tregatti-tech/ESP32ECG/Visualisation/tregatti_stable_front.jpg

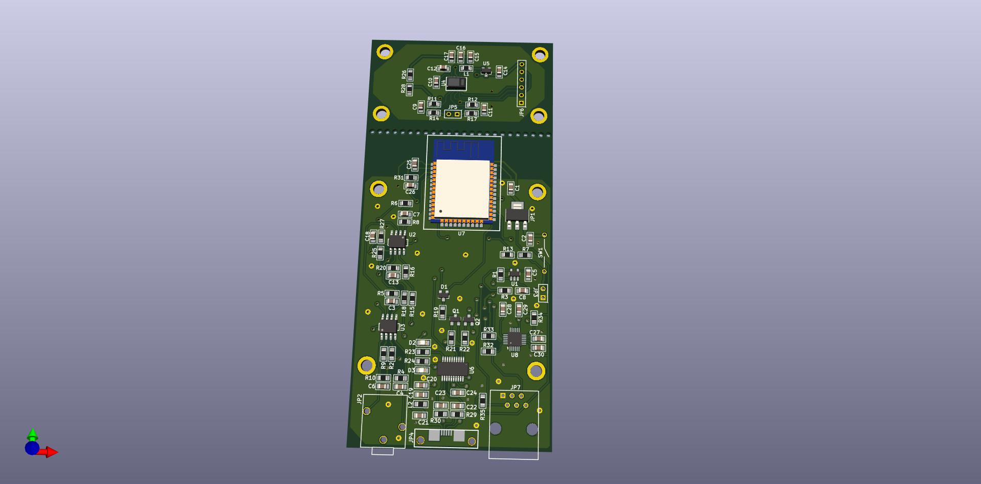
Visualisation/tregatti_stable_front.jpg
