tregatti-tech/ESP32ECG/README.md

# ESP32ECG
Open design/code version of ECG device based on esp32

Website https://tregatti.tech
Email info@
