tregatti-tech/ESP32ECG/Presentations/DevBG_IoT.pdf

v

Следете актуалните обяви за Internet of things

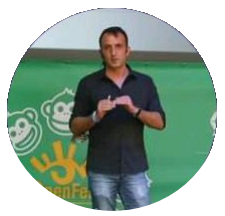
[picture p2: figure]

# Примерен код за кардиография чрез esp32

таймер, ацп(adc), филтри, i2c, websocket, canvas, etc.

Петко Маринов

Ладоре ООД

# Сигналът

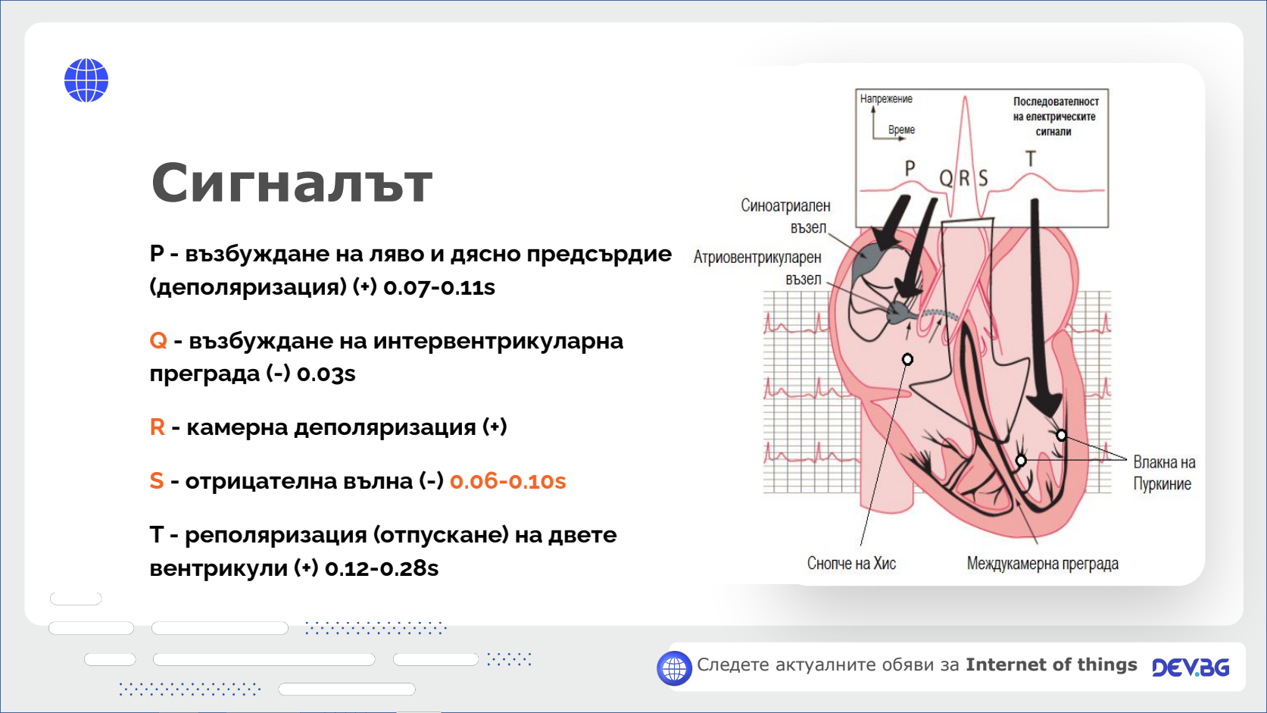
[picture p3: page 2]

v

P - възбуждане на ляво и дясно предсърдие (деполяризация) (+) 0.07-0.11s

Q - възбуждане на интервентрикуларна преграда (-) 0.03s

R - камерна деполяризация (+)

S - отрицателна вълна (-) 0.06-0.10s

Т - реполяризация (отпускане) на двете вентрикули (+) 0.12-0.28s

# Усилвателя

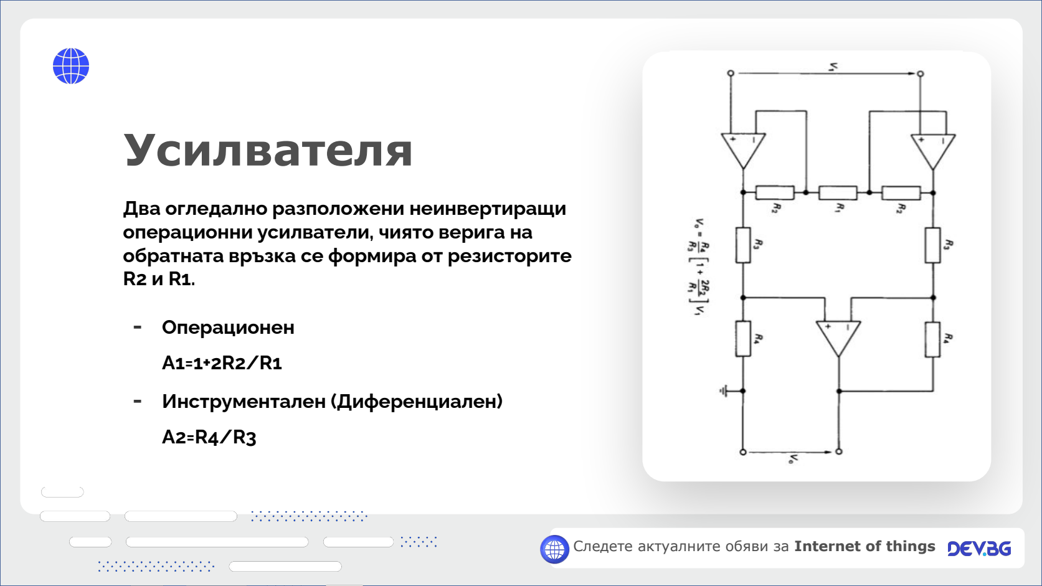
[picture p4: page 3]

v

Два огледално разположени неинвертиращи операционни усилватели, чиято верига на обратната връзка се формира от резисторите R2 и R1.

- Операционен
A1=1+2R2/R1
- Инструментален (Диференциален) A2=R4/R3

# АЦП/ADC

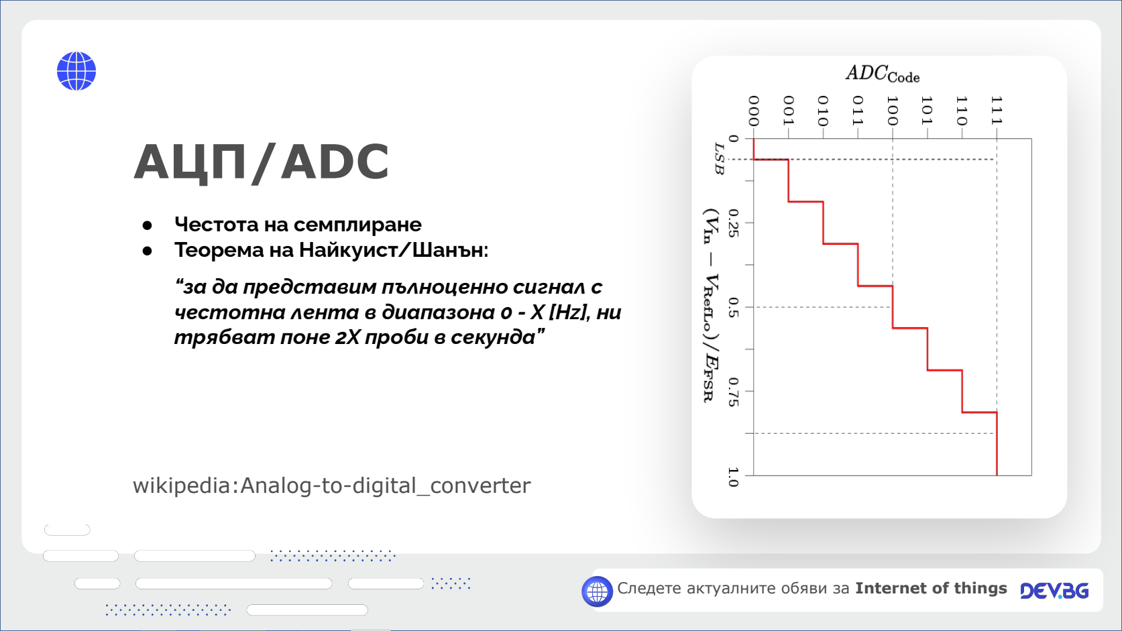
[picture p5: page 4]

v

- Честота на семплиране
- Теорема на Найкуист/Шанън:
“за да представим пълноценно сигнал с честотна лента в диапазона 0 - Х [Hz], ни трябват поне 2Х проби в секунда”

wikipedia:Analog-to-digital_converter

# esp32 АЦП/ADC

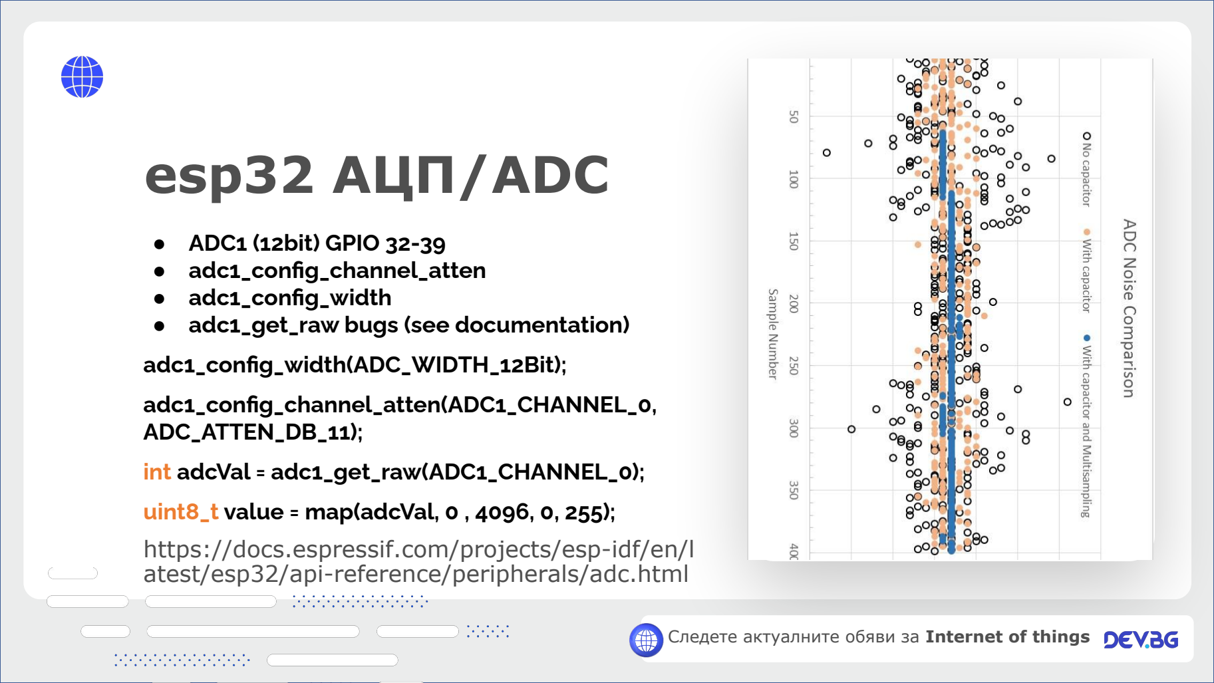
[picture p6: page 5]

v

- ADC1 (12bit) GPIO 32-39
- adc1_config_channel_atten
- adc1_config_width
- adc1_get_raw bugs (see documentation) adc1_config_width(ADC_WIDTH_12Bit); adc1_config_channel_atten(ADC1_CHANNEL_0, ADC_ATTEN_DB_11);
int adcVal = adc1_get_raw(ADC1_CHANNEL_0); uint8_t value = map(adcVal, 0 , 4096, 0, 255);

https://docs.espressif.com/projects/esp-idf/en/latest/esp32/api-reference/peripherals/adc.html

# Timer-esp32

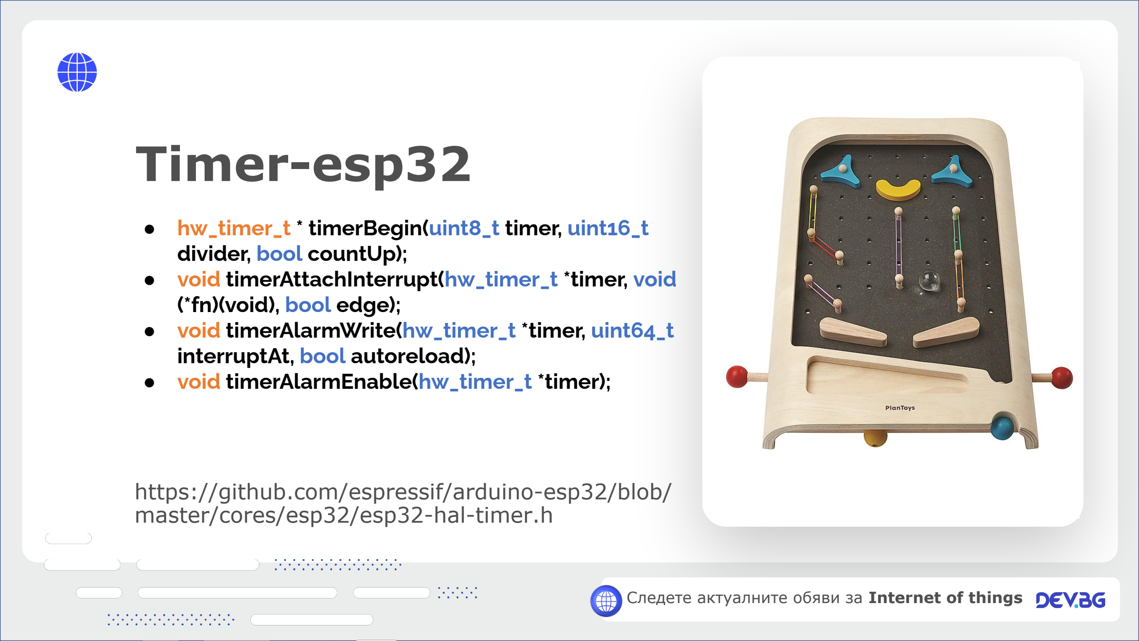
[picture p7: page 6]

v

- hw_timer_t * timerBegin(uint8_t timer, uint16_t divider, bool countUp);
- void timerAttachInterrupt(hw_timer_t *timer, void (*fn)(void), bool edge);
- void timerAlarmWrite(hw_timer_t *timer, uint64_t interruptAt, bool autoreload);
- void timerAlarmEnable(hw_timer_t *timer);

https://github.com/espressif/arduino-esp32/blob/master/cores/esp32/esp32-hal-timer.h

v

hw_timer_t * timer = NULL;
portMUX_TYPE timerMutex = portMUX_INITIALIZER_UNLOCKED; int main(void) { //snip …
//…

timer = timerBegin(0, 80, true); // 80 is the divider timerAttachInterrupt(timer, &onTimer, true); timerAlarmWrite(timer, 4000, true);//4000 == 250/second timerAlarmEnable(timer);
}

v

#include <driver/adc.h>

void IRAM_ATTR onTimer() { //portENTER_CRITICAL_ISR(&timerMutex);

int adcVal = adc1_get_raw(ADC1_CHANNEL_0); uint8_t value = map(adcVal, 0 , 4096, 0, 255); ekgBuffer[bufferPointer++] = value;

if (bufferPointer == EKG_BUFFER_MAX ) { bufferPointer = 0;
transmit = true;
}
//portEXIT_CRITICAL_ISR(&timerMutex); }

# Шум

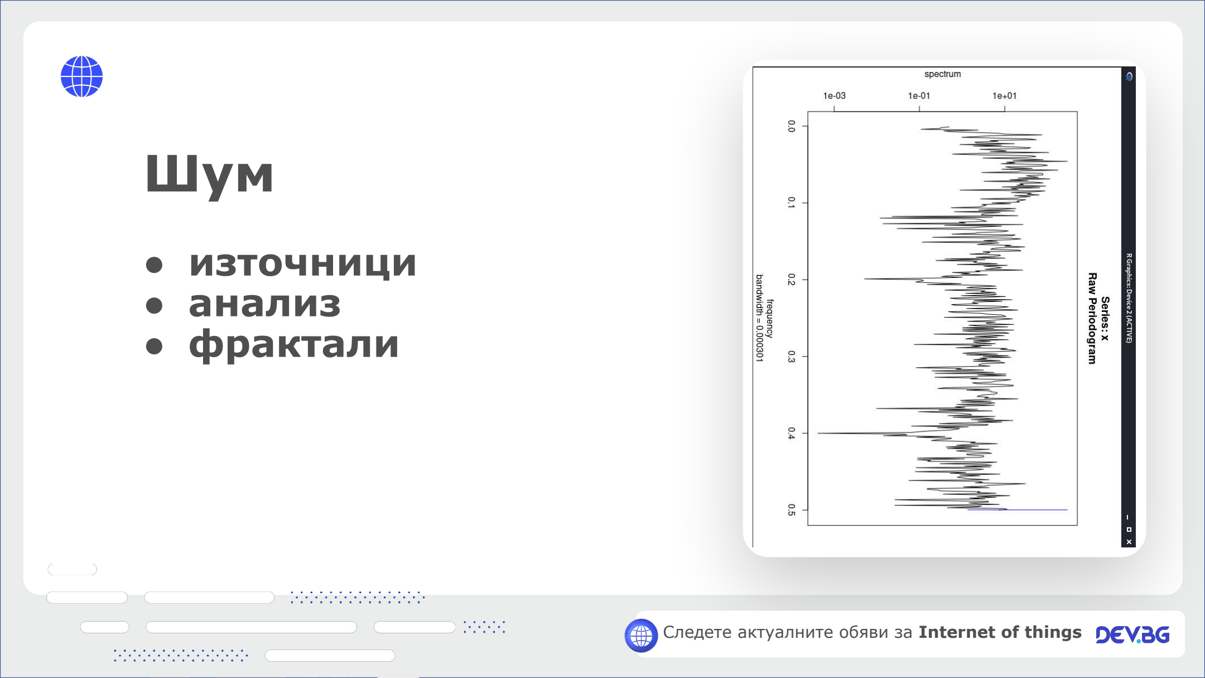
[picture p8: page 9]

v

## - източници - анализ - фрактали

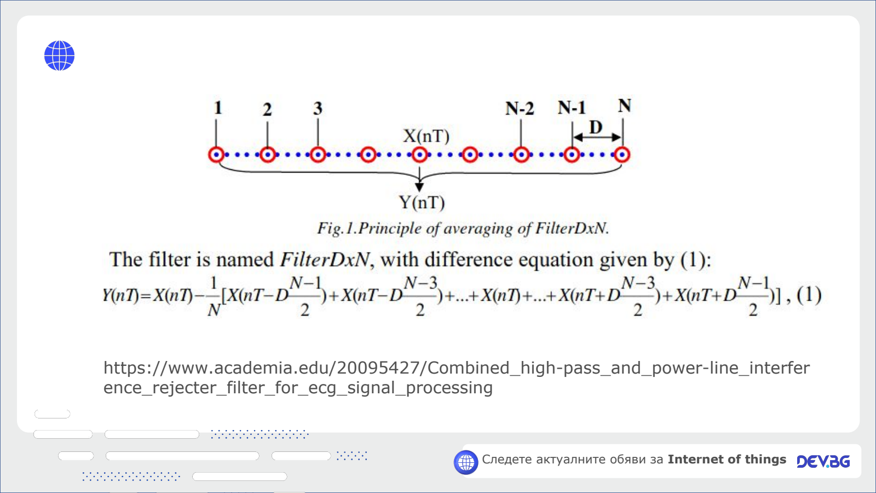
[picture p9: page 10]

v

https://www.academia.edu/20095427/Combined_high-pass_and_power-line_interference_rejecter_filter_for_ecg_signal_processing (https://www.academia.edu/20095427/Combined_high-pass_and_power-line_interference_rejecter_filter_for_ecg_signal_processing)

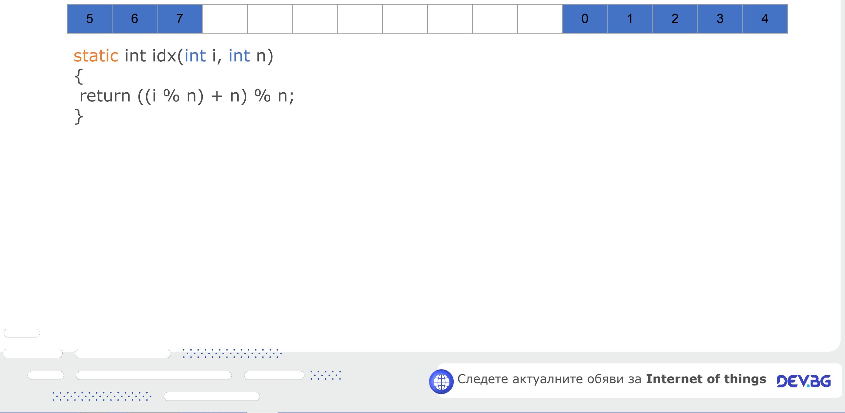
[picture p10: figure]
static int idx(int i, int n) { return ((i % n) + n) % n; }

v

for(int i = 0; i < EKG_BUFFER_MAX ; i++)
{
filterBuffer[i] = 255 - 128 + (ekgBuffer [i] -
( ekgBuffer [idx(i - 40,EKG_BUFFER_MAX )] + ekgBuffer [idx(i - 35,EKG_BUFFER_MAX )] + ekgBuffer [idx(i - 30,EKG_BUFFER_MAX )] + ekgBuffer [idx(i - 25,EKG_BUFFER_MAX )] + ekgBuffer [idx(i - 20,EKG_BUFFER_MAX )] + ekgBuffer [idx(i - 15,EKG_BUFFER_MAX )] + ekgBuffer [idx(i - 10,EKG_BUFFER_MAX )] + ekgBuffer [idx(i - 5,EKG_BUFFER_MAX )] + ekgBuffer [i]
+ ekgBuffer [idx(i + 5,EKG_BUFFER_MAX )] + ekgBuffer [idx(i + 10,EKG_BUFFER_MAX )] + ekgBuffer [idx(i - 15,EKG_BUFFER_MAX )] + ekgBuffer [idx(i + 20,EKG_BUFFER_MAX )] + ekgBuffer [idx(i + 25,EKG_BUFFER_MAX )] + ekgBuffer [idx(i + 30,EKG_BUFFER_MAX )] + ekgBuffer [idx(i + 35,EKG_BUFFER_MAX )] + ekgBuffer [idx(i + 40,EKG_BUFFER_MAX )] )
/17);
}
-40 | -35 | -30 | -25 | -20 | -15 | -10 | -5 | 0 | 5 | 10 | 15 | 20 | 25 | 30 | 35 | 40

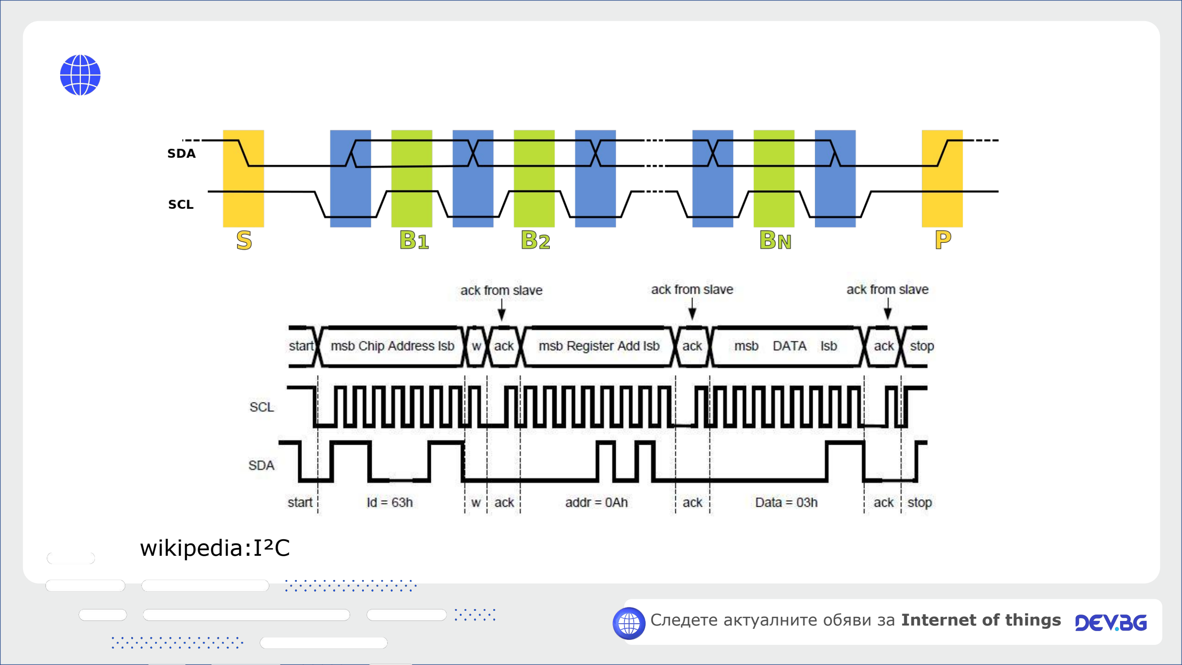
[picture p11: page 13]

v

wikipedia:I²C

v

#include <Wire.h>

#include <max86150.h>

#define I2C_SDA 19

#define I2C_SCL 18

TwoWire I2C6050 = TwoWire(0); …
MAX86150 max86150Sensor;
uint16_t ppgunsigned16;
…
pinMode (I2C_SDA,OUTPUT);
pinMode (I2C_SCL,OUTPUT);
…
status = I2C6050.begin(I2C_SDA,I2C_SCL, 10000);
…

https://datasheets.maximintegrated.com/en/ds/MAX86150.pdf

v

for (byte i = 8; i < 120; i++) {
I2C6050.beginTransmission (i);
if (I2C6050.endTransmission () == 0) { //found device }
}

if (max86150Sensor.begin(I2C6050, 10000,0x5e) == false)
{
Serial.println("MAX86150 was not found. Please check wiring/power. "); }else {
Serial.println("partid:" + max86150Sensor.readPartID()); max86150Sensor.setup();
}

https://github.com/Protocentral/protocentral_max86150_ecg_ppg

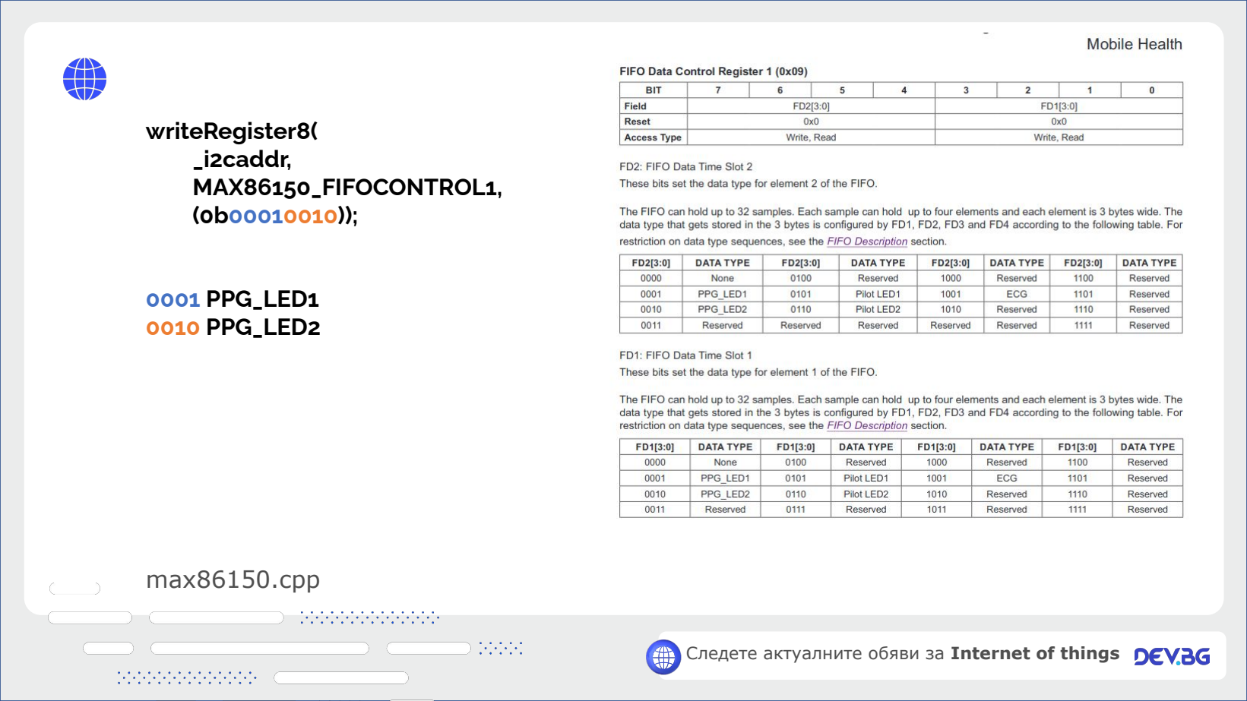
[picture p12: page 16]

v

writeRegister8(
_i2caddr,
MAX86150_FIFOCONTROL1,
(0b00010010));

0001 PPG_LED1
0010 PPG_LED2

max86150.cpp

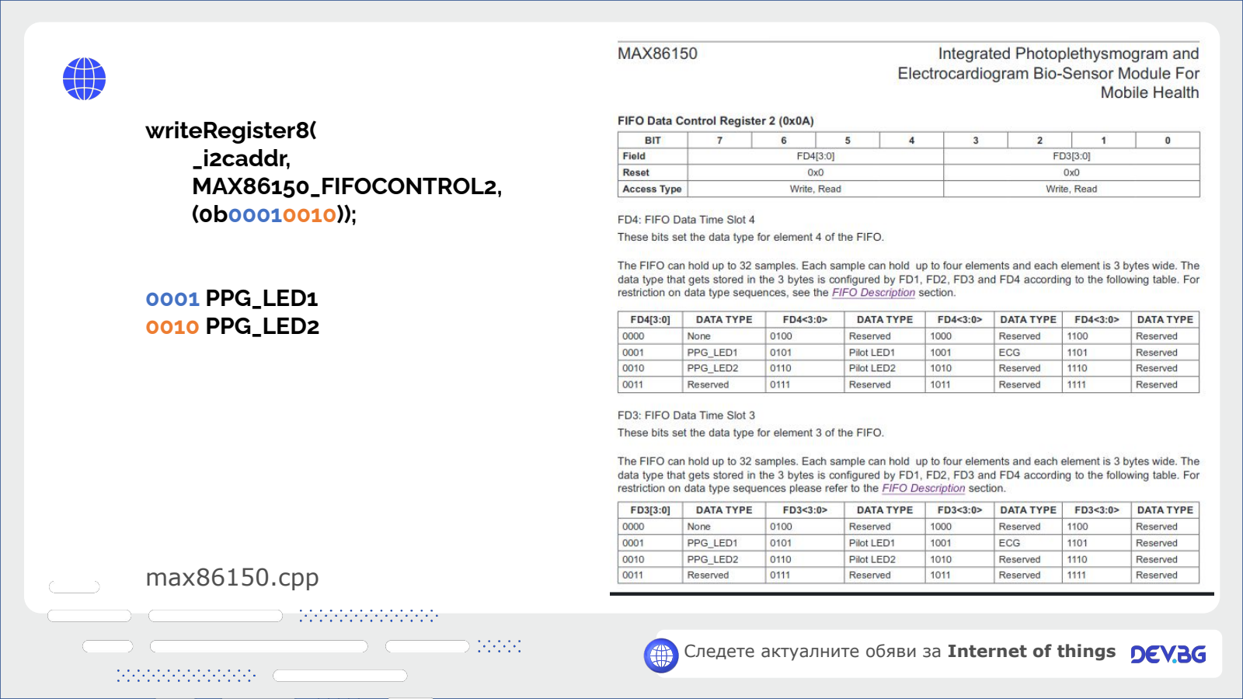
[picture p13: page 17]

v

writeRegister8(
_i2caddr,
MAX86150_FIFOCONTROL2,
(0b00010010));

0001 PPG_LED1
0010 PPG_LED2

max86150.cpp

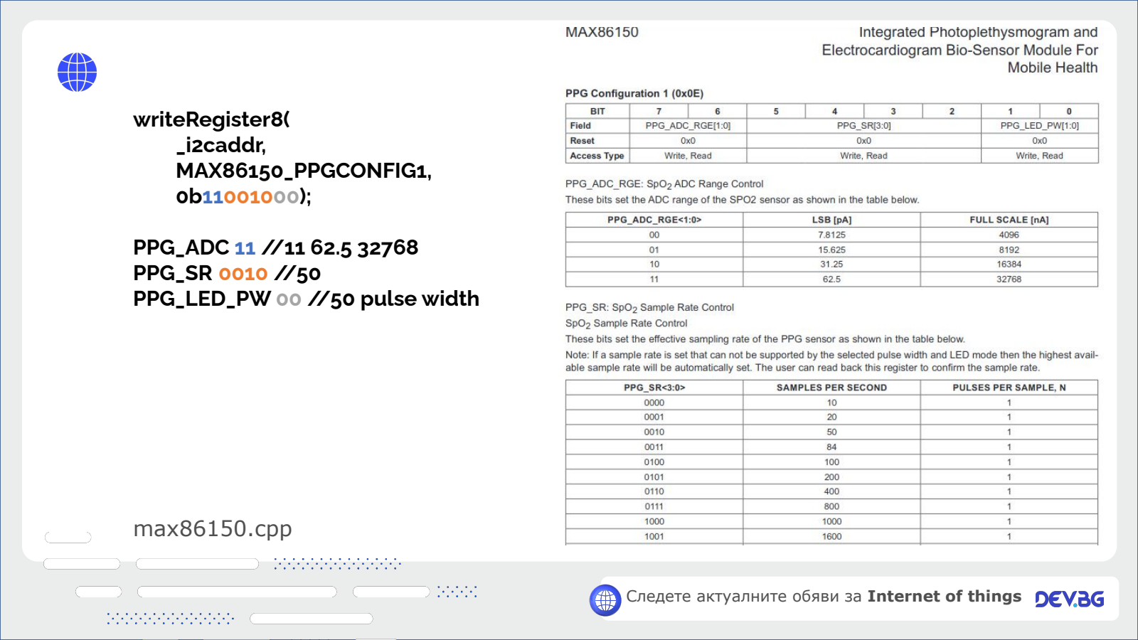
[picture p14: page 18]

v

writeRegister8(
_i2caddr,
MAX86150_PPGCONFIG1,
0b11001000);

PPG_ADC 11 //11 62.5 32768 PPG_SR 0010 //50
PPG_LED_PW 00 //50 pulse width

max86150.cpp

v

if(max86150Sensor.check()>0)
{
ppgunsigned16 = (uint16_t) (max86150Sensor.getFIFORed()>>2); Serial.print("PPG:");
Serial.println(ppgunsigned16);
}

https://github.com/Protocentral/protocentral_max86150_ecg_ppg

v

#include <WebServer.h>

#include <WebSocketsServer.h>

WebServer server(80);
WebSocketsServer webSocket = WebSocketsServer(8080);

…

webSocket.begin();
webSocket.onEvent(webSocketEvent);

server.on("/", handle_OnConnect); server.onNotFound(handle_NotFound);

server.begin();

v

void webSocketEvent(uint8_t num, WStype_t type, uint8_t * payload, size_t length) {

switch(type) {
case WStype_DISCONNECTED:
break;
case WStype_CONNECTED:
IPAddress ip = webSocket.remoteIP(num); webSocket.sendTXT(num, "{\"connected\":true}"); break;
case WStype_TEXT:
Serial.printf("[%u] get Text: %s\n", num, payload); break;
case WStype_ERROR:
Serial.printf("WS_ERROR");
break;
}
}

v

void handle_OnConnect() {
Serial.println("handle on connect routine"); server.send(200, "text/html", SendHTML()); }

String SendHTML(){
String ptr = "<!DOCTYPE html> <html>\n";
….
ptr +="<canvas id='eeg' width='1000' height='255'></canvas>"; ...
ptr +="</html>\n";
return ptr;
}

v

ptr +="<script>";
ptr +="var connection = new WebSocket('ws://' + location.hostname + ':8080/', ['arduino']);"; ptr +="connection.onopen = function () {";
ptr +="connection.onerror = function (error) {";
ptr +="connection.onmessage = function (e) {";
ptr +="var msg = JSON.parse(e.data);";
ptr +="console.log(msg.type);";
ptr +="if(msg.type == \"ppg\") { document.getElementById(\"ppg\").innerHTML = msg.data + '%' ;};";
ptr +="if(msg.type == \"ecg\") {";
ptr += "data = msg.data.split(',');";
ptr += "var canvas = document.getElementById('eeg');"; ptr += "var ctx = canvas.getContext('2d');";
ptr += "ctx.beginPath();";

v

ptr += "for(i=0;i<data.length - 1;i++) {"; ptr += "ctx.lineTo(i,data[i]);";
ptr += "ctx.stroke();";

v

# Демо

v

# Благодаря!

info@tregatti.tech

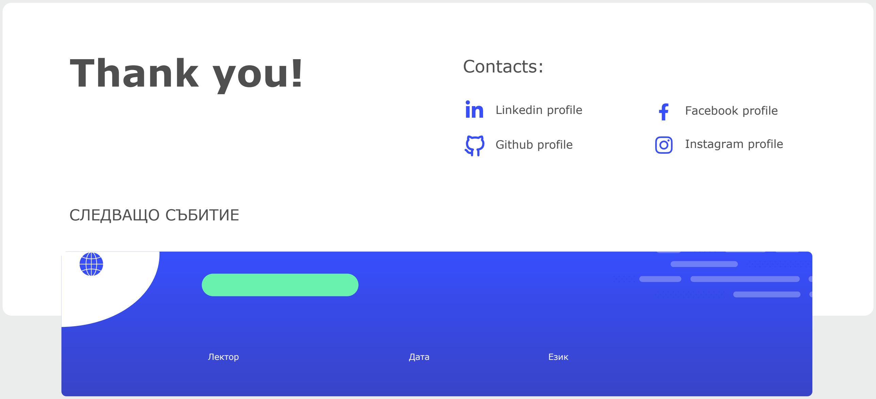
[picture p15: figure]
Thank you!; СЛЕДВАЩО СЪБИТИЕ; Лектор; Дата; Език; Contacts:; Linkedin profile; Github profile; Facebook profile; Instagram profile
