tregatti-tech/ESP32ECG/Presentations/Tux conf.pdf

# Интерфейс за ЕКГ /с отворен код/

github.com/tregatti-tech

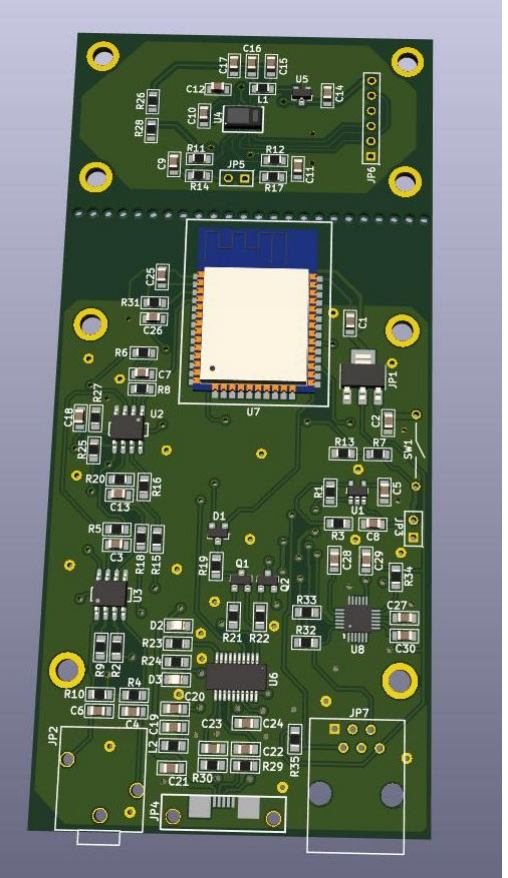
[picture p16: figure]

## За проекта

- Отворен дизайн/отворен код
- Базиран на esp32
- Добро съотношение сигнал/шум
- Лесна употреба през wifi/bluetooth
- Възможност за edge тензори
- Демо - Openfest 2021

https://github.com/tregatti-tech

# Прототип v2

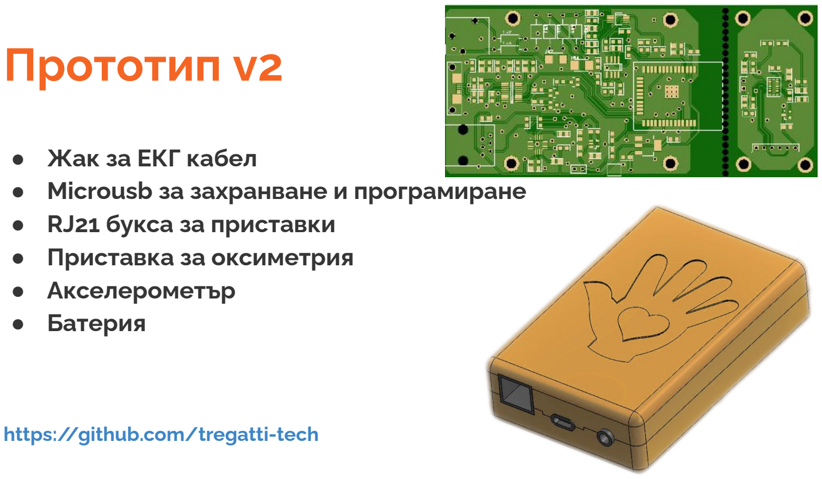
[picture p17: page 3]

- Жак за ЕКГ кабел
- Microusb за захранване и програмиране
- RJ21 букса за приставки
- Приставка за оксиметрия
- Акселерометър
- Батерия

https://github.com/tregatti-tech

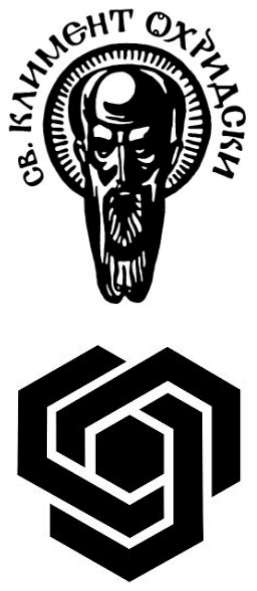
[picture p18: figure]

## Формулата

- Проектно партньорство
- СУ - ФМИ /курс JavaScript напреднали/
- ТУ - катедра Електроника/Мед.приб
- Ентусиазиран екип
- vladimarkova
- nakata122

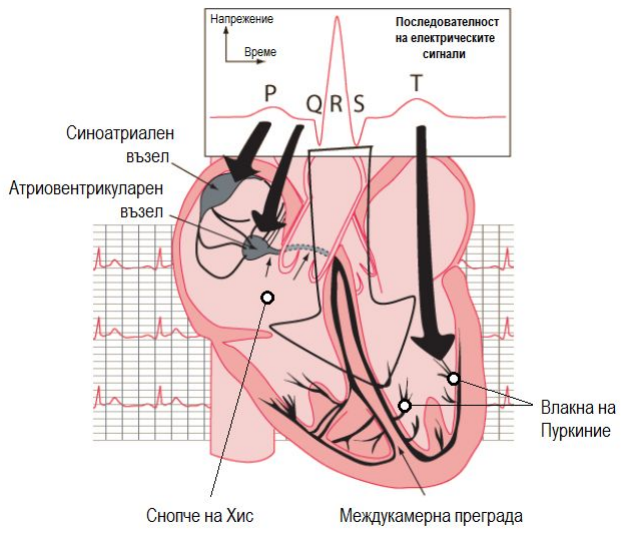
[picture p19: figure]

## QRS комплекс

P - възбуждане на ляво и дясно предсърдие (деполяризация) (+) 0.07-0.11s

Q - възбуждане на интервентрикуларна преграда (-) 0.03s

R - камерна деполяризация (+)

S - отрицателна вълна (-) 0.06-0.10s

Т - реполяризация (отпускане) на двете вентрикули (+) 0.12-0.28s

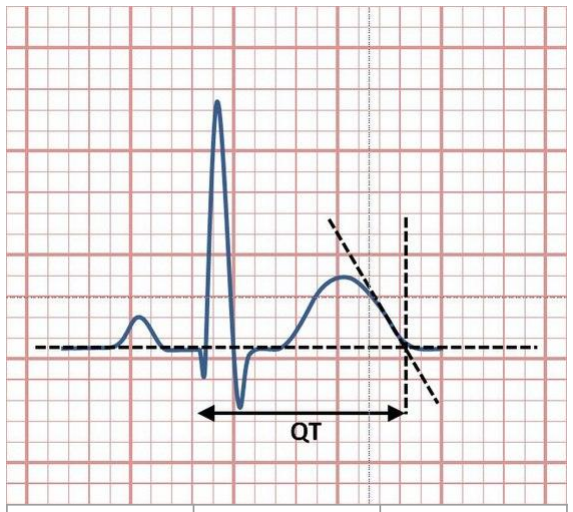
[picture p20: figure]

# Морфология

### - Kомплекс - Елементи - Мащабът е важен - Калибрация - Времеделене

Image source: wiki:QT_interval

P wave | 0.25±0.05 mV | 110 ±20ms
QRS | 1.60 ± 0.5 mV | 100 ms ± 20 ms
R wave | 1.60 ± 0.5 mV
S wave | 0.25 * R
T wave | -0.5 mV | 160ms

D3

JavaScript library for visualizing data using web standards. D3

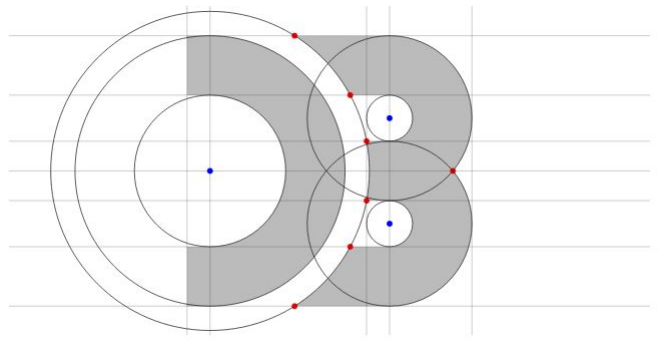
[picture p21: figure]

helps you bring data to life using SVG, Canvas and HTML

object constancy: a graphical element that represents a particular data point can be tracked visually through the transition.

https://observablehq.com/staff-picks

Image source: observablehq.com

# Сигнал / шум

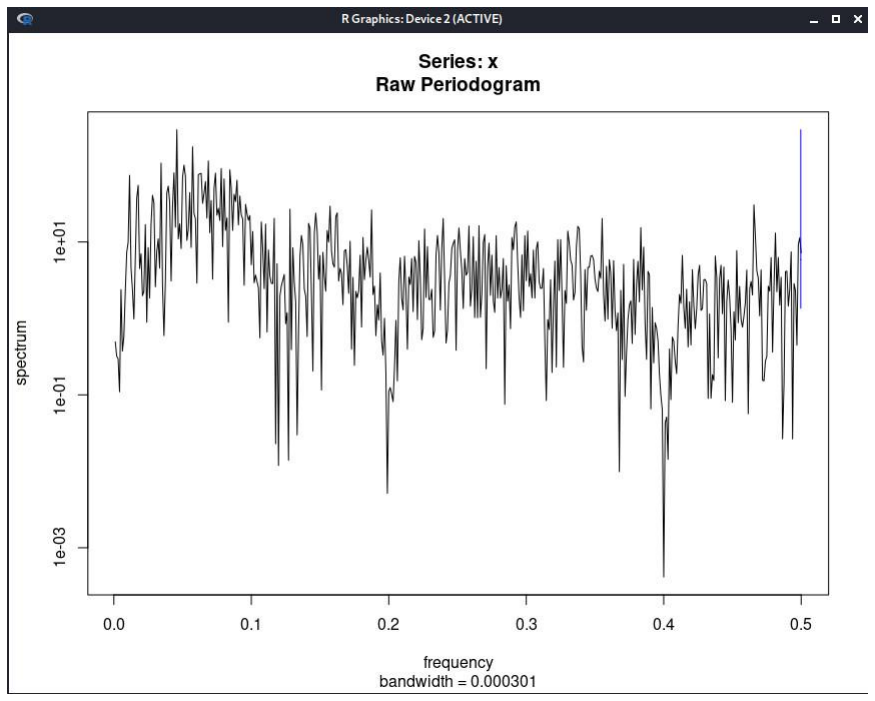
[picture p22: figure]

- Основни източници
- Анализ
- Филтри
- Фрактали

https://www.circuitlab.com/

## Филтър 50hz

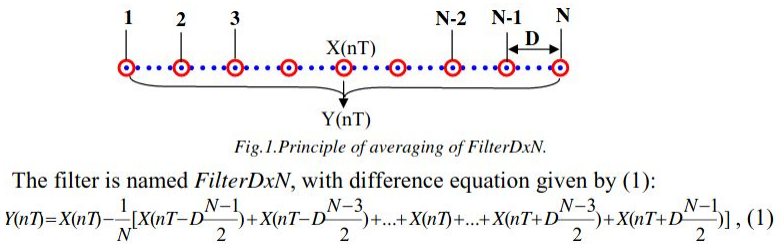
[picture p23: figure]

https://www.academia.edu/20095427/Combined_high-pass_and_power-line_interference_rejecter_filter_for_ecg_signal_processing Проф. Илиев, Доц. Табаков ТУ, Д-р Кръстева БАН

### D = Fs (sampling)/Ft (signal)

## Филтър 50hz

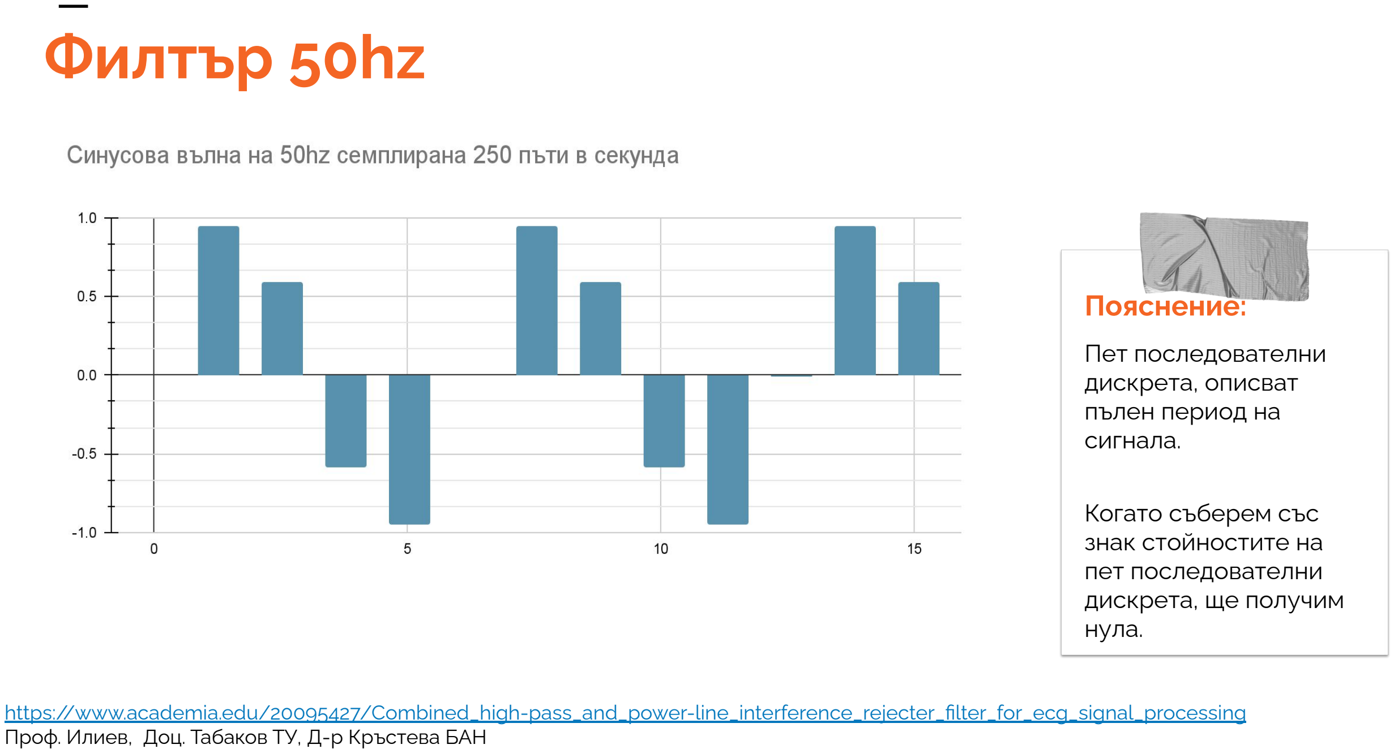
[picture p24: page 10]

https://www.academia.edu/20095427/Combined_high-pass_and_power-line_interference_rejecter_filter_for_ecg_signal_processing Проф. Илиев, Доц. Табаков ТУ, Д-р Кръстева БАН

Пояснение:

Пет последователни
дискрета, описват
пълен период на
сигнала.

Когато съберем със
знак стойностите на
пет последователни
дискрета, ще получим
нула.

## Алгоритъм за намиране на QRS комплекс

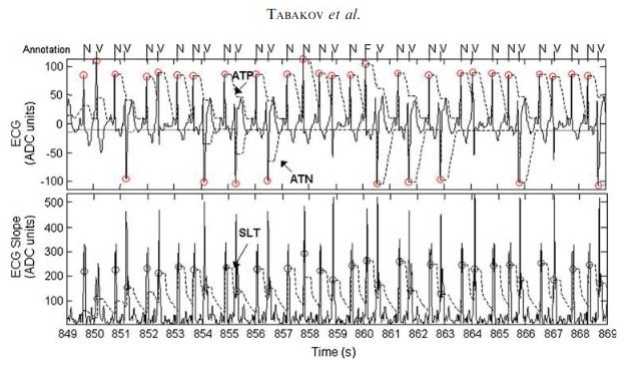
[picture p25: figure]

### 1) Sign (ECGi−ECGi−n) * Sign (ECGi−ECGi+n)>0 2) (ECGSlopei > SLT/2 И ECGi > 2ATP) ИЛИ

### (ECGSlopei > SLT/2 И ECGi < 2ATN)

https://www.researchgate.net/publication/6482993_Real-time_detection_of_pathological_cardiac_events_in_the_electrocardiogram Проф. Илиев, Доц. Табаков ТУ, Д-р Кръстева БАН

## Демо

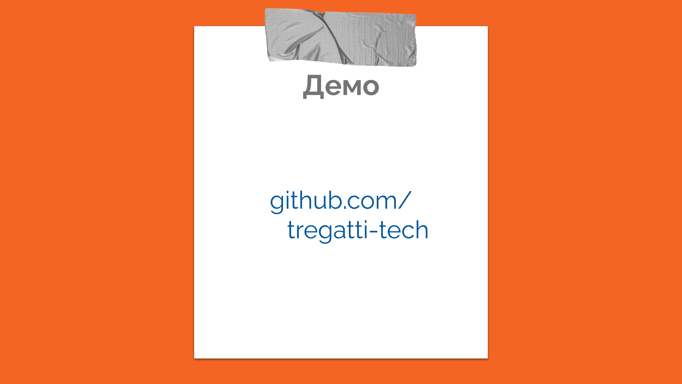
[picture p26: page 12]

## github.com/ tregatti-tech

## Благодаря!

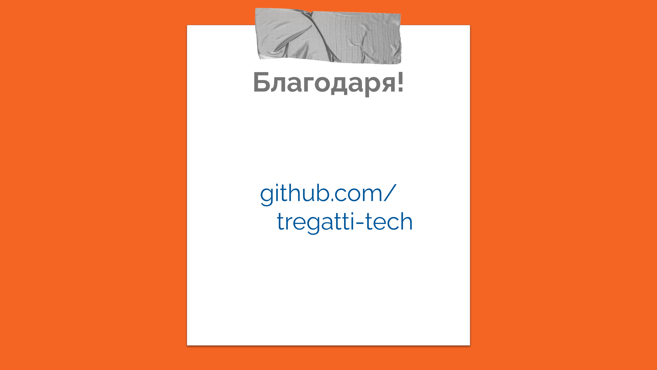
[picture p27: page 13]

## github.com/ tregatti-tech
