tregatti-tech/ESP32ECG/Presentations/openfest.pdf

# Слушай

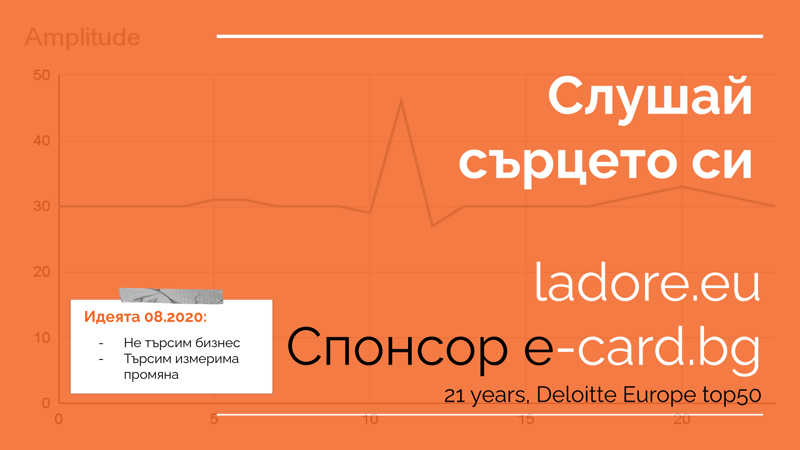
[picture p28: page 1]

# сърцето си

# ladore.eu Спонсор e-card.bg

21 years, Deloitte Europe top50

Идеята 08.2020:

- Не търсим бизнес
- Търсим измерима
промяна

## Защо сме тук?

За да разкажем докъде сме стигнали. За да потърсим ентусиасти.
За да си сверим часовника.
За да намерим обратна връзка. За да начертаем бъдещите стъпки.

## Началото или откъде започнахме?

- Проучихме медицински статии и специализирана литература
- Разговаряхме с медици и IT и хардуерни специалисти
- Проучихме технологични възможности
- Закупихме сензори и хардуерни решения

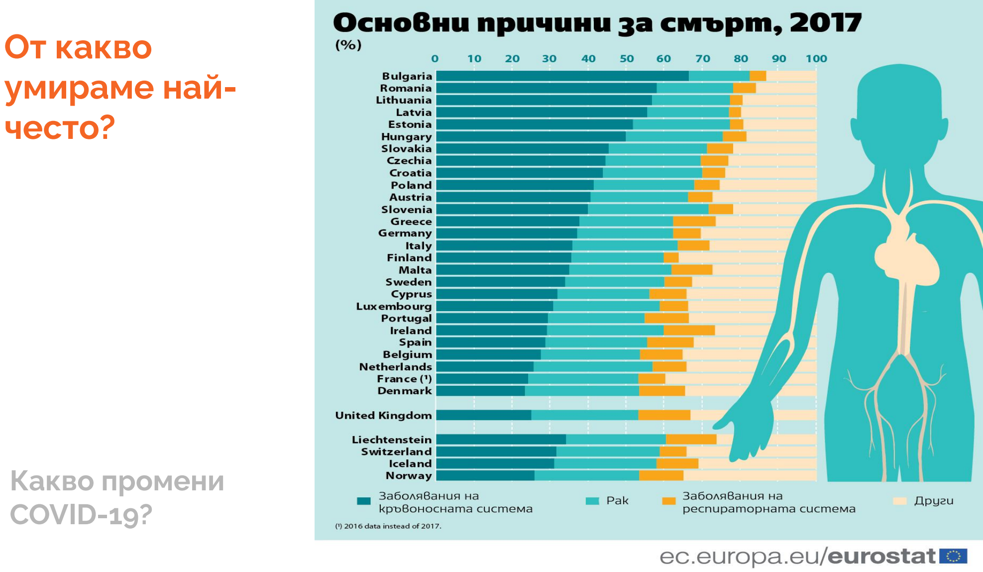
[picture p29: page 4]

От какво
умираме най-често?

Какво промени
COVID-19?

## Технологично

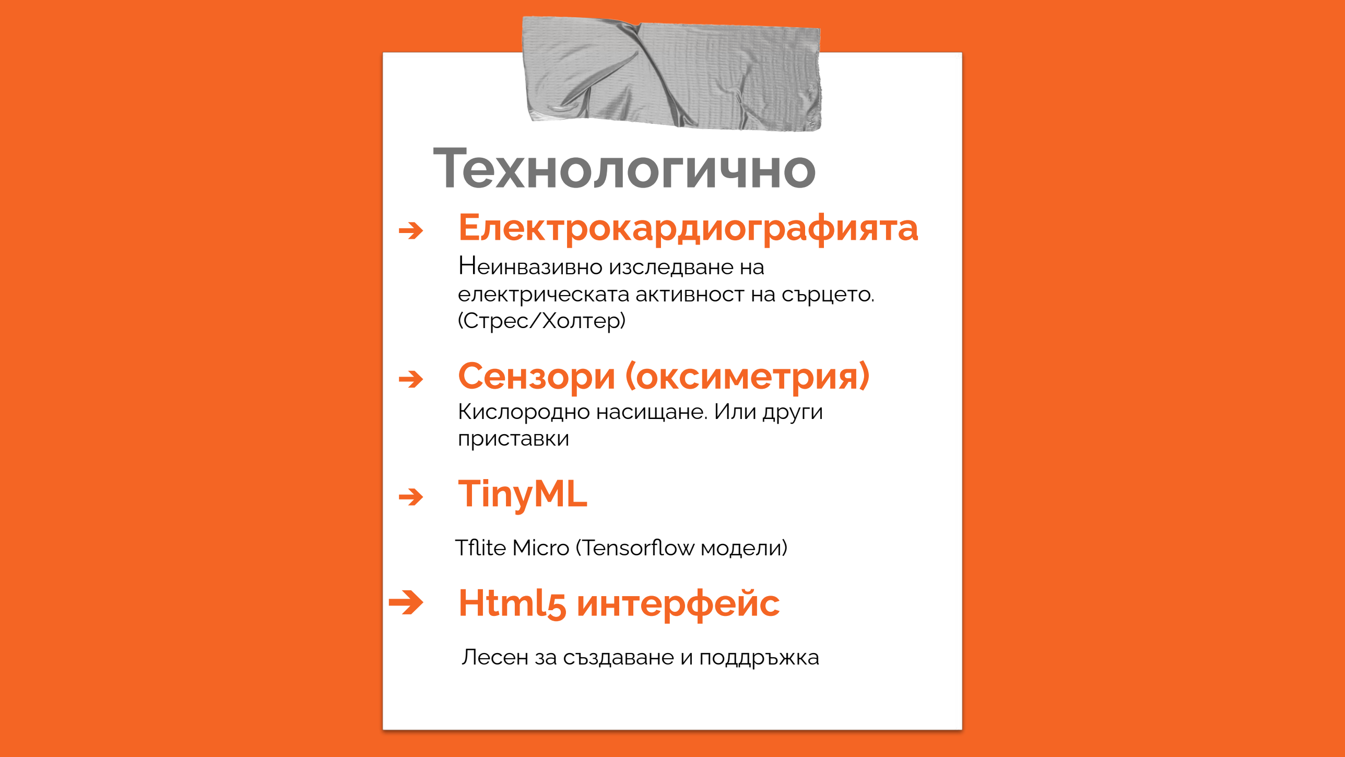
[picture p30: page 5]

➔ | Електрокардиографията Неинвазивно изследване на електрическата активност на сърцето. (Стрес/Холтер)
➔ | Сензори (оксиметрия) Кислородно насищане. Или други приставки
➔ | TinyML
| Tflite Micro (Tensorflow модели)
➔ Html5 интерфейс
| Лесен за създаване и поддръжка

## Видове отвеждания

Прекордиални отвеждания - V1, V2,V3 (цветове на светофара)

Периферни отвеждания - aVR, aVL, aVF - дясна ръка, лява ръка, ляв крак

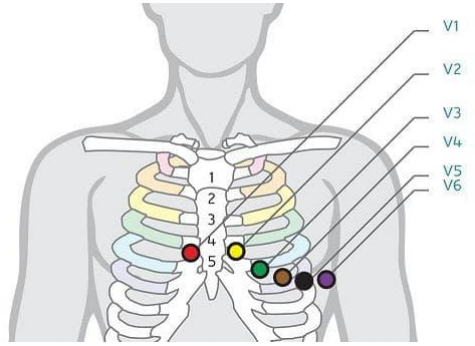
[picture p31: figure]

medpedia.framar.bg


## QRS комплекс

P - възбуждане на ляво и дясно предсърдие (деполяризация) (+) 0.07-0.11s

Q - възбуждане на интервентрикуларна преграда (-) 0.03s

R - камерна деполяризация (+)

S - отрицателна вълна (-) 0.06-0.10s

Т - реполяризация (отпускане) на двете вентрикули (+) 0.12-0.28s

## Тривиални видове

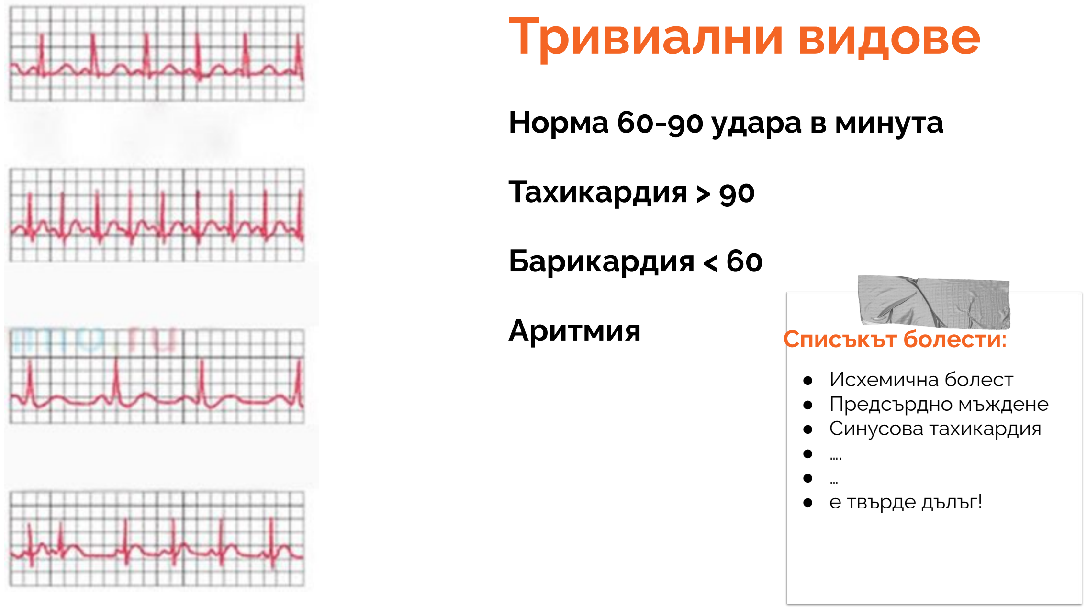
[picture p32: page 8]

Норма 60-90 удара в минута

Тахикардия > 90

Барикардия < 60

Аритмия | Списъкът болести:
| ● Исхемична болест ● Предсърдно мъждене ● Синусова тахикардия ● …. ● … ● е твърде дълъг!

## Синоатриален възел

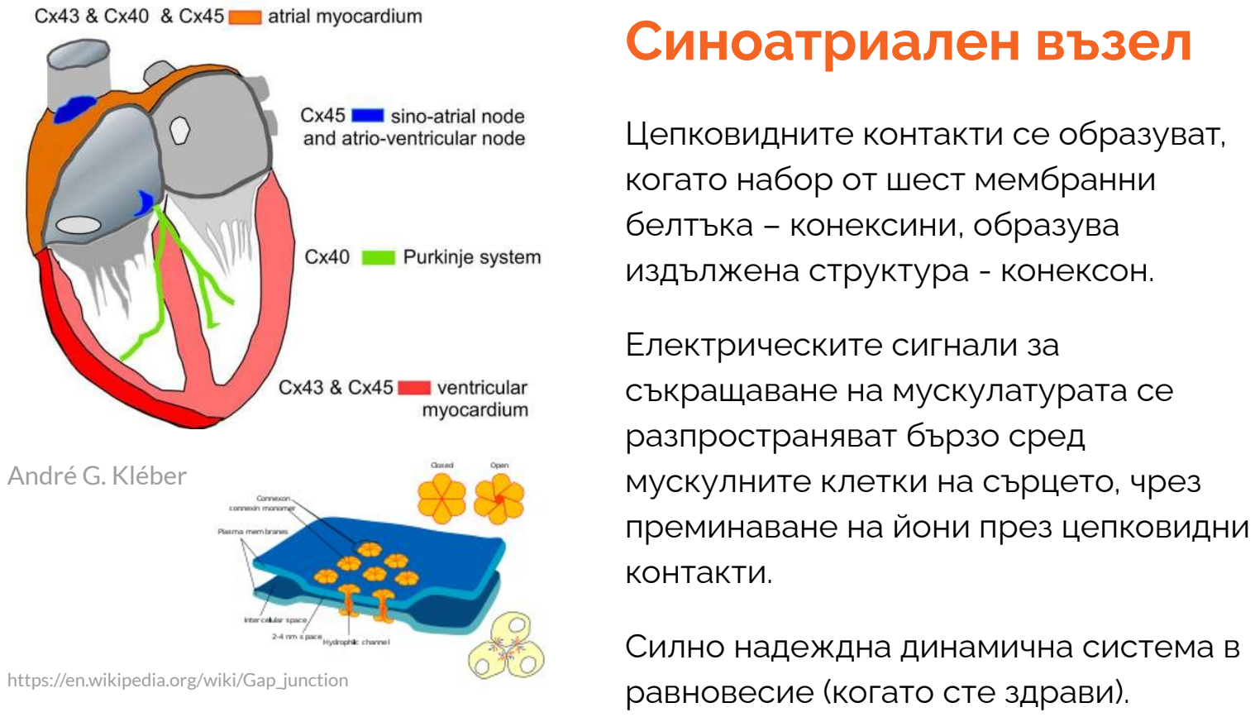
[picture p33: page 9]

Цепковидните контакти се образуват, когато набор от шест мембранни белтъка – конексини, образува издължена структура - конексон.

Електрическите сигнали за
съкращаване на мускулатурата се разпространяват бързо сред мускулните клетки на сърцето, чрез преминаване на йони през цепковидни контакти.

Силно надеждна динамична система в равновесие (когато сте здрави).

André G. Kléber

https://en.wikipedia.org/wiki/Gap_junction

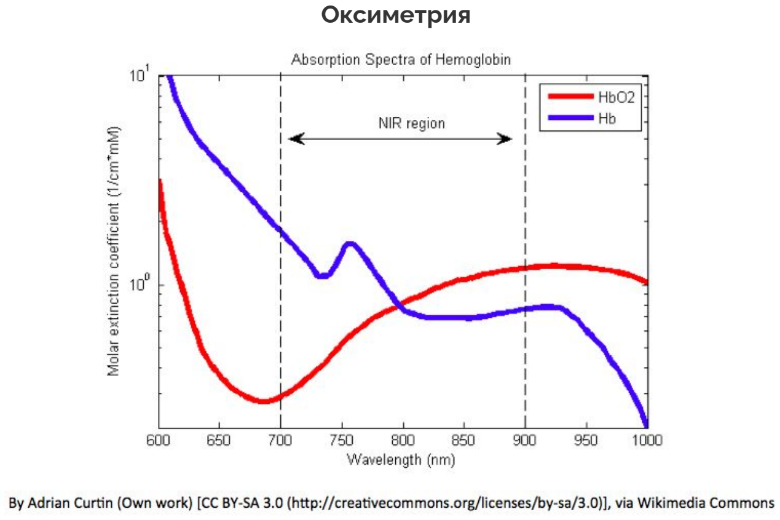
[picture p34: page 10]

Оксиметрия

# Избрахме esp32

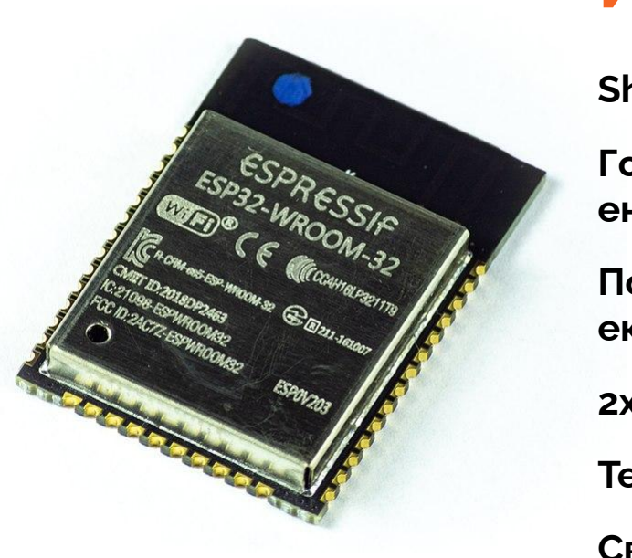
[picture p35: figure]

Shielded and certified
Голяма общност от
ентусиасти
Ползва библиотеките на
екосистемата на ардуино
2x cores, 80 - 240 MHz
Tensorflow Lite
Свързва се с iPhone

Photo by https://commons.wikimedia.org/wiki/User:Ubahnverleih

# Защо tinyML?

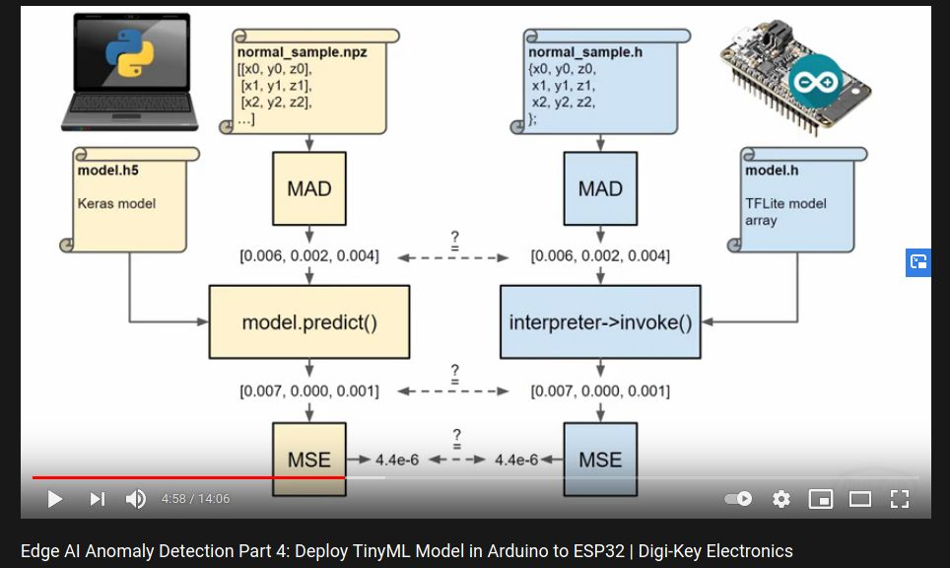
[picture p36: figure]

Тензорите (CPD) помагат:

- при класификация на
нерегулярно сърцебиене
- намирането на
алтерниращи T вълни
- установяването на
промените в ЕКГ,
предхождащи сърдечния
арест

https://github.com/ShawnHymel/tinyml-example-anomaly-detection

# Какво пропуснах до тук?

Благодарности:
Факултет по Електронна техника и технологии (ТУ) Олимекс
Микроелектроника
Къде са данните?
Уреди за оксиметрия.

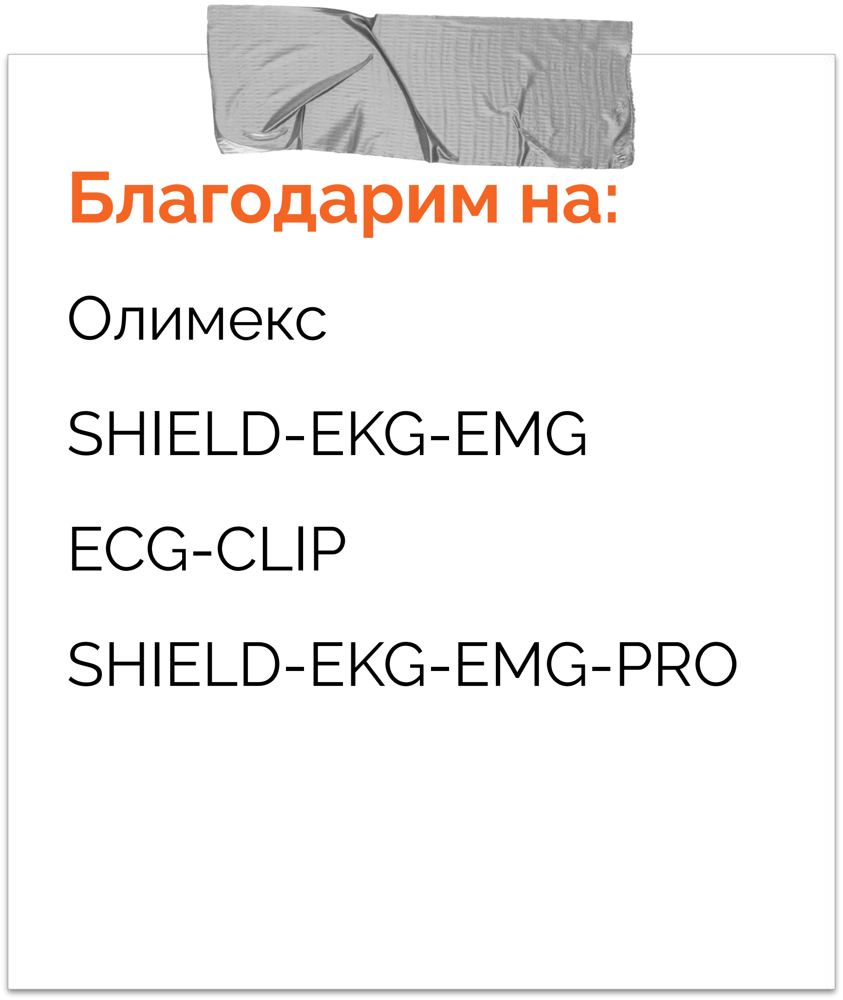
[picture p37: figure]
Благодарим на:; Олимекс; SHIELD-EKG-EMG; ECG-CLIP; SHIELD-EKG-EMG-PRO

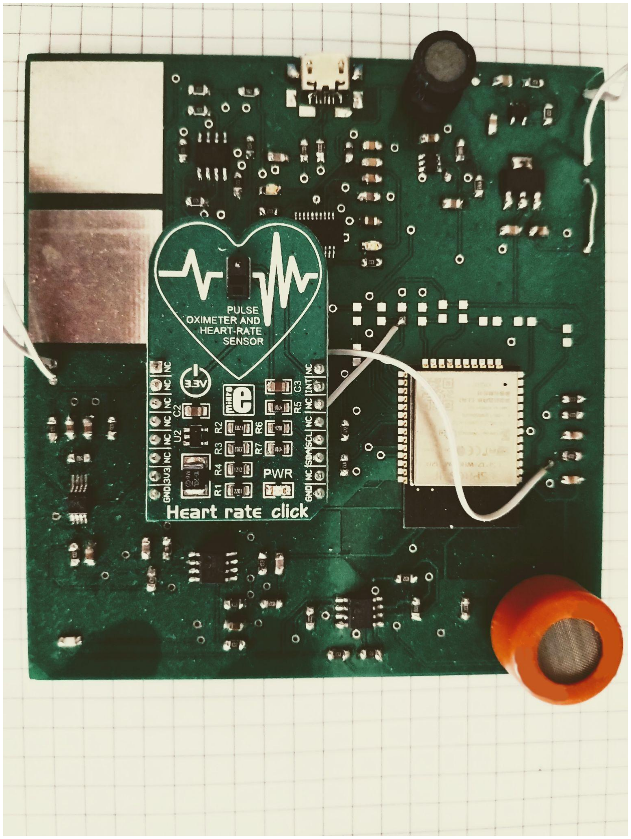
[picture p38: figure]

# Прототип v1

- Неергономичен
- Проблеми с ЕКГ
- Оксиметрията е
неизползваема
- Липсва акселерометър
- Батерията е неподходяща
- Бяхме забравили RTS и DTR

# Прототип v2

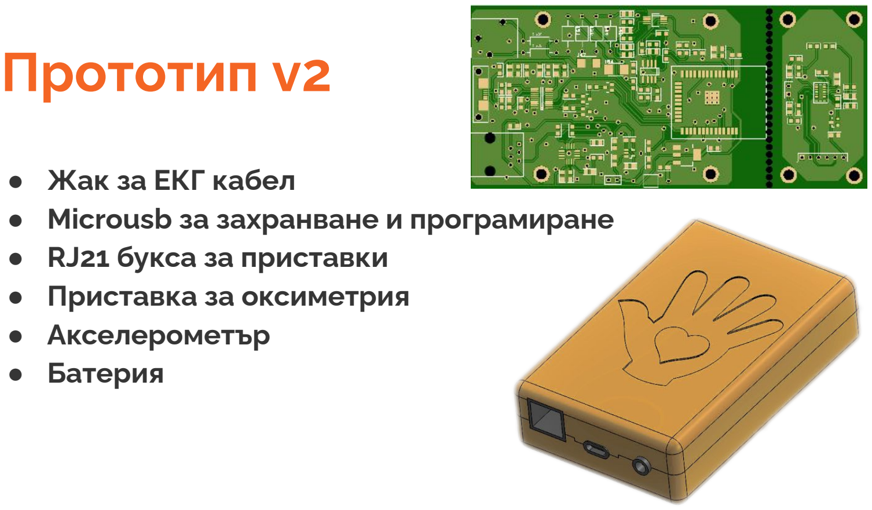
[picture p39: page 15]

- Жак за ЕКГ кабел
- Microusb за захранване и програмиране
- RJ21 букса за приставки
- Приставка за оксиметрия
- Акселерометър
- Батерия

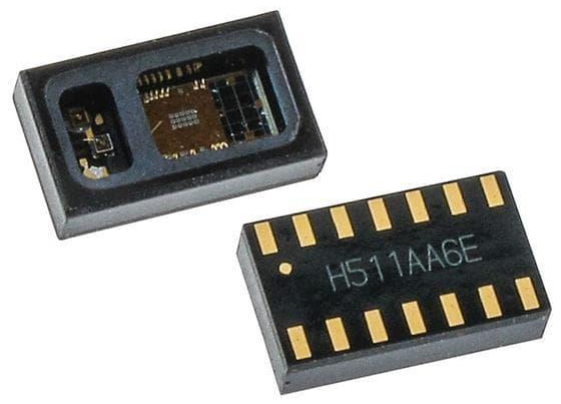
[picture p40: figure]

# MAX86150

Интегрирано ЕКГ (ADC)
Оксиметрия
Синхронизирана по
пулсова вълна
Вградени филтри
I2C протокол
lib:86150 (protocentral)

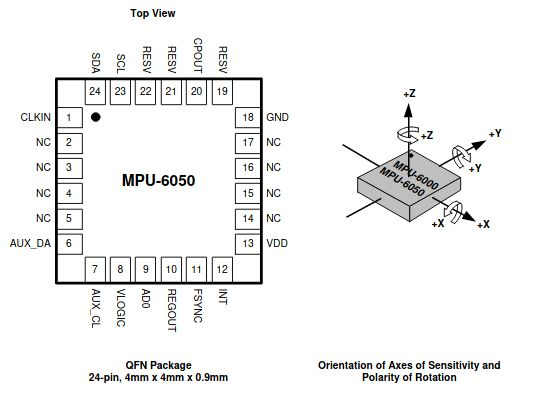
[picture p41: figure]

# MPU6050

3D жироскоп
3D акселерометър
I2C
lib:Adafruit_MPU6050

# Принципна схема

Видове усилватели:
- Операционен
A1=1+2R2/R1
- Инструментален
(Диференциален)
A2=R4/R3

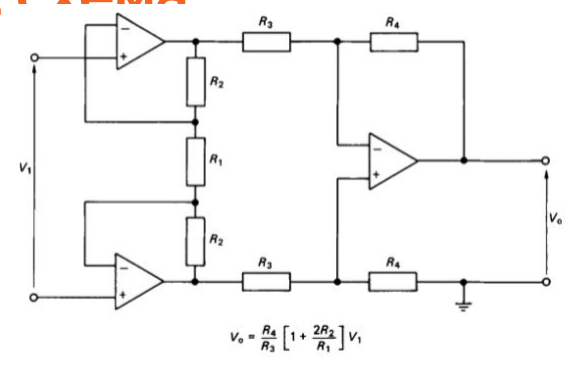
[picture p42: figure]

Първото стъпало на инструменталния усилвател предстравлява реално огледално разположени неинвертиращи операционни усилватели, чиято верига на обратната връзка

https://www.circuitlab.com/ | се формира от резисторите R2 и R1. Виртуалният нулев потенциал се явява „в средата“ на R1.

# Схемата на ЕКГ усилвателя

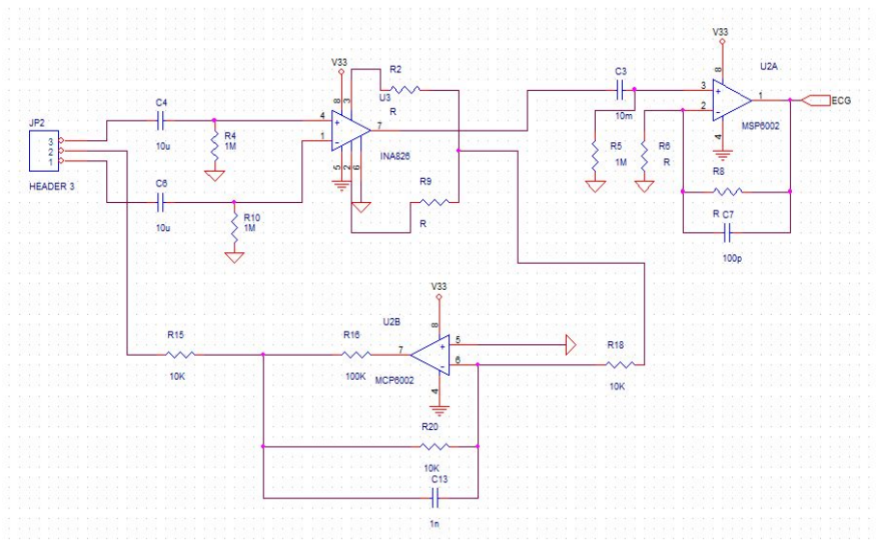
[picture p43: figure]

1) Неинвертиращи
усилватели mcp6002
2) Диференциален
усилвател Ina826

https://www.circuitlab.com/

# Сигнал / шум


- Основни източници
- Анализ
- Филтри
- Фрактали

https://www.circuitlab.com/

## Филтър 50hz


https://www.academia.edu/20095427/Combined_high-pass_and_power-line_interference_rejecter_filter_for_ecg_signal_processing Проф. Илиев, Доц. Табаков ТУ, Д-р Кръстева БАН

D = Fs (sampling)/Ft (signal)

## Филтър 50hz

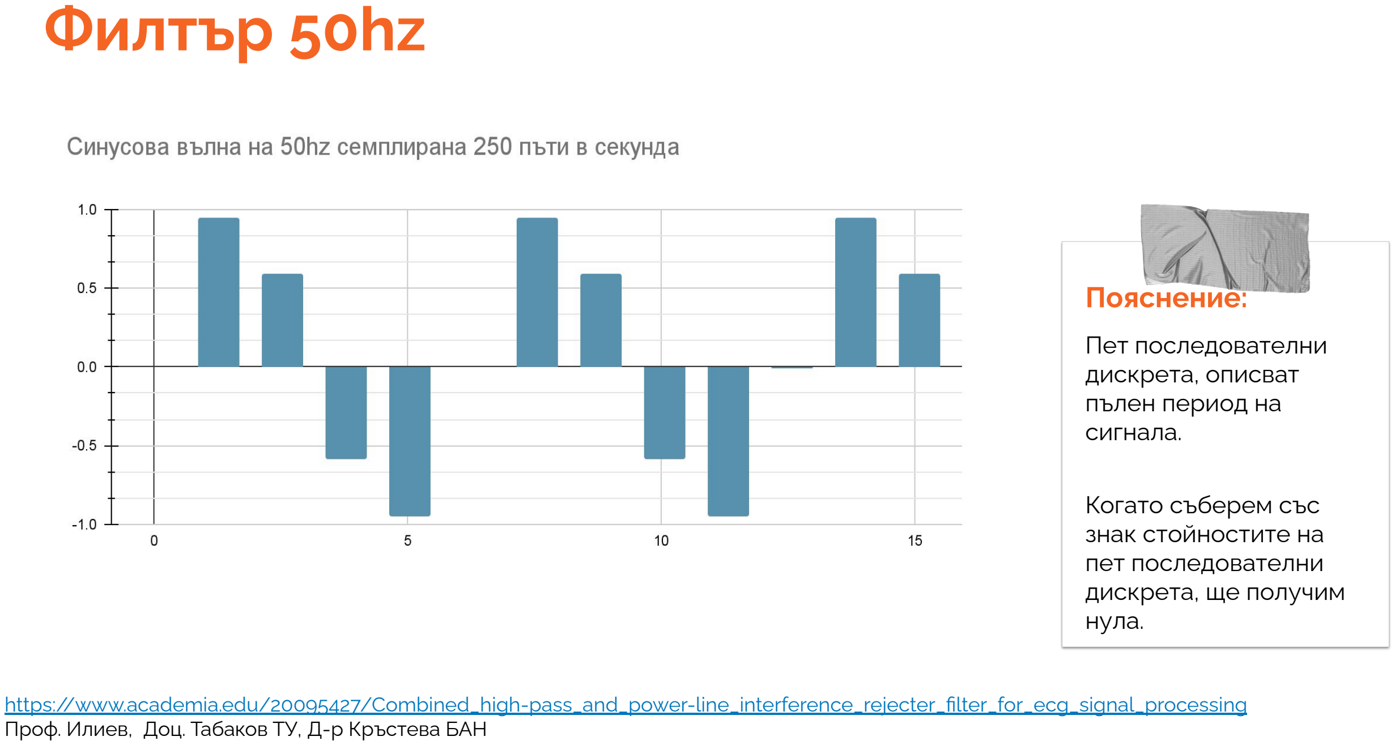
[picture p44: page 22]

https://www.academia.edu/20095427/Combined_high-pass_and_power-line_interference_rejecter_filter_for_ecg_signal_processing Проф. Илиев, Доц. Табаков ТУ, Д-р Кръстева БАН

Пояснение:

Пет последователни
дискрета, описват
пълен период на
сигнала.

Когато съберем със
знак стойностите на
пет последователни
дискрета, ще получим
нула.

## Филтър 50hz

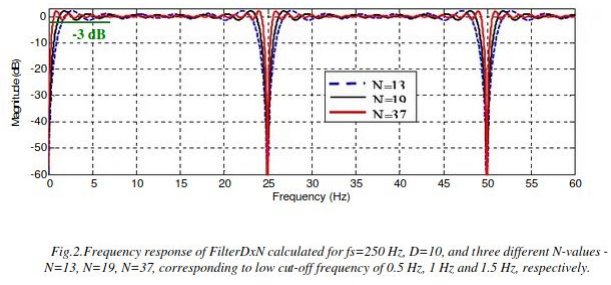
[picture p45: figure]

https://www.academia.edu/20095427/Combined_high-pass_and_power-line_interference_rejecter_filter_for_ecg_signal_processing Проф. Илиев, Доц. Табаков ТУ, Д-р Кръстева БАН

## Алгоритъм за намиране на QRS комплекс


1) Sign (ECGi−ECGi−n) · Sign (ECGi−ECGi+n)>0
2) (ECGSlopei > SLT или сумата |ECGi - ECG(i-n)| i=1..5 ) ИЛИ (ECGSlopei > SLT/2 И ECGi > 2ATP) ИЛИ
(ECGSlopei > SLT/2 И ECGi < 2ATN)

https://www.researchgate.net/publication/6482993_Real-time_detection_of_pathological_cardiac_events_in_the_electrocardiogram Проф. Илиев, Доц. Табаков ТУ, Д-р Кръстева БАН

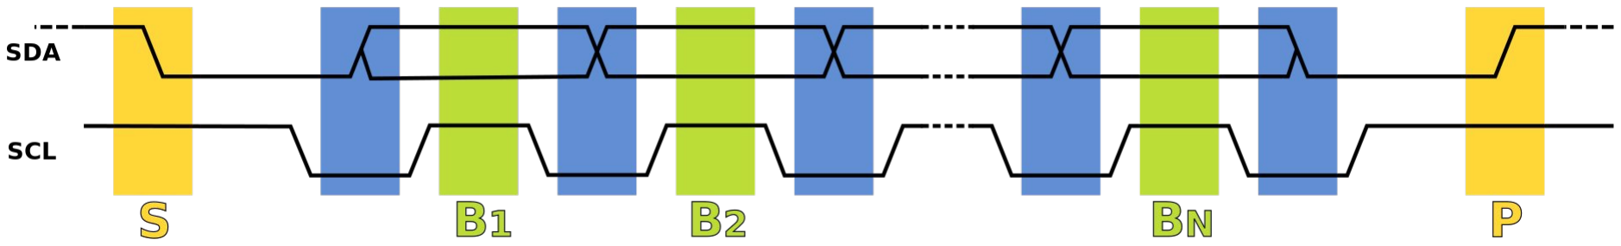
[picture p46: figure]

I2C шина 7бит адресируема, 100 Kbit/s - 3.4 Mbit/s

От max86150 получаваме … NAK
Честотата се задава от master-a на шината.
Можем да намерим ниска честота на шината, съобразена с дължината на кабела и устройствата
А може би сме забравили 4.7к пулъп резисторите?

Source https://en.wikipedia.org/wiki/I²C

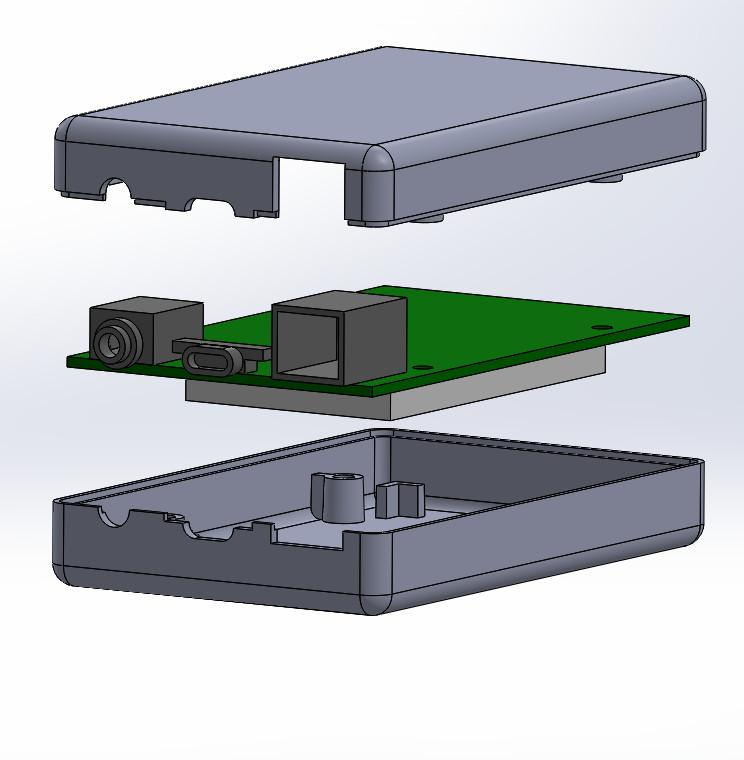
[picture p47: figure]

# Кутията

3D принтирана
Отделен отсек за
батерия

https://www.bobi-voikov.com/

# Защо отворен дизайн и отворен код?

Надяваме се на:
- помощта на ентусиасти в различни области
- желанието на ползвателите да предоставят данните през отворен лиценз

# Други отворени проекти

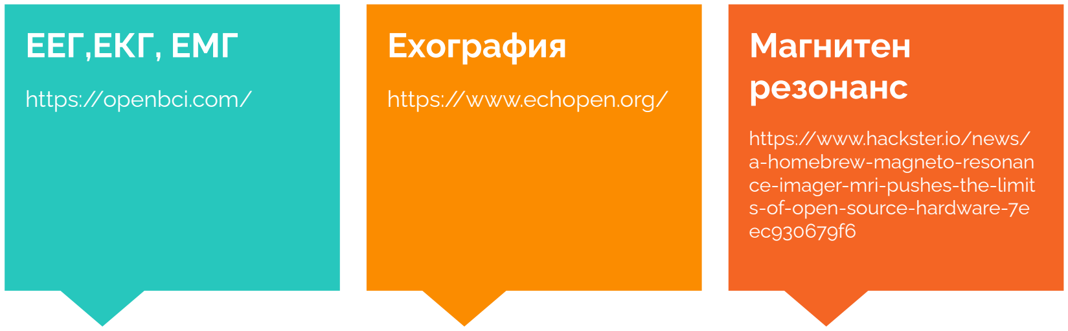
[picture p48: figure]
Магнитен резонанс; https://www.hackster.io/news/ a-homebrew-magneto-resonan ce-imager-mri-pushes-the-limit s-of-open-source-hardware-7e ec930679f6; ЕЕГ,ЕКГ, ЕМГ; https://openbci.com/; Ехография; https://www.echopen.org/

## Исторически - Augustus Desiré Waller 1887!

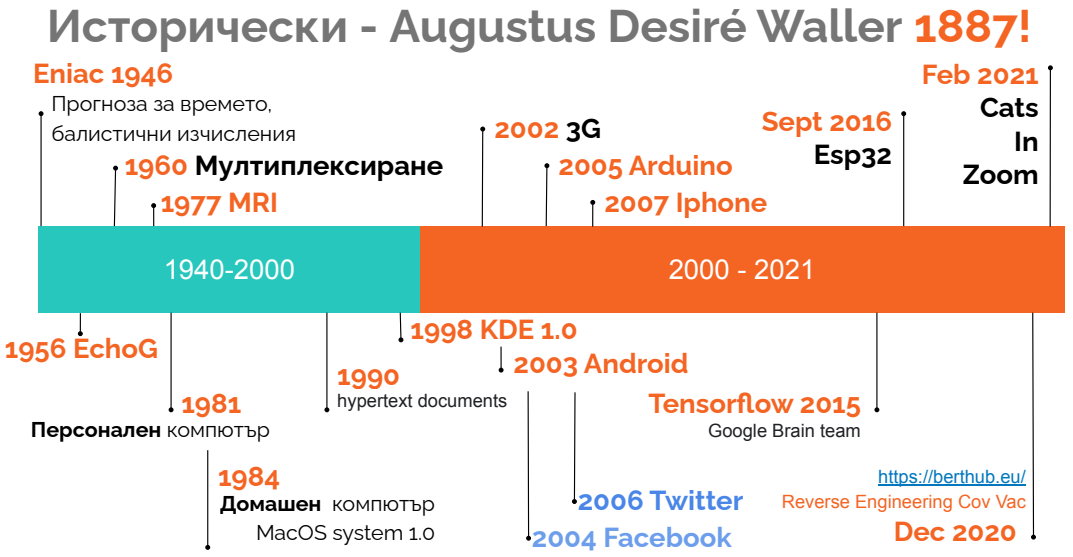
[picture p49: page 29]
Sept 2016 Esp32; Персонален компютър 1984 Домашен компютър MacOS system 1.0; 1956 EchoG; 2005 Arduino 2007 Iphone; 2004 Facebook; 2006 Twitter; Feb 2021 Cats In Zoom

Eniac 1946
Прогноза за времето,
балистични изчисления
1960 Мултиплексиране
1977 MRI

1998 KDE 1.0
1990 | 2003 Android

hypertext documents

Tensorflow 2015

Google Brain team

https://berthub.eu/
Dec 2020

Reverse Engineering Cov Vac

## Благодаря!

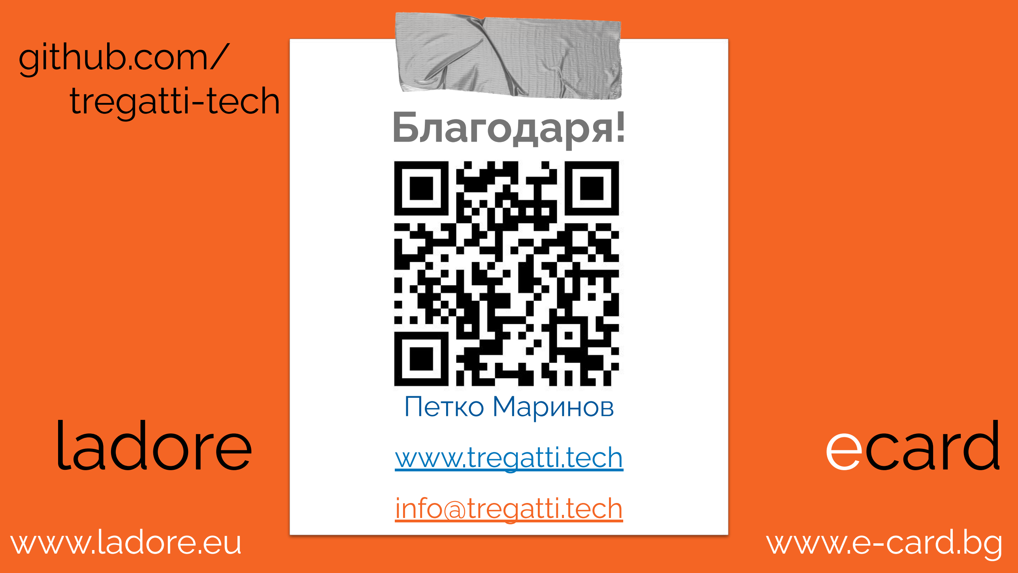
[picture p50: page 30]

Петко Маринов
www.tregatti.tech
info@tregatti.tech
ladore | ecard
www.ladore.eu | www.e-card.bg

github.com/
tregatti-tech
