tregatti-tech/ESP32ECG/KiCAD_files/tregatti-ecg/bom.ods

Source: | tregatti_stable.sch
Tool: | Eeschema 5.1.10
Component Count: | 88
Ref | Qnty | Value | Cmp name | Footprint | Description | Vendor
C1, C2, C5, C8, C10, | 5 | 1u | C0805 1.0uF 16V X7R SAMSUNG | C0805 | Unpolarized capacitor
C3, C4, C6, C15, C16, C19, | 6 | 4.7u | C0805 4.7uF 25V X5R SAMSUNG | C0805 | Unpolarized capacitor
C7, | 1 | 100p | C0805 100pF 50V C0G SAMSUNG | C0805 | Unpolarized capacitor
C9, C11, C22, C23, | 4 | 47p | C0805 47pF 50V C0G SAMSUNG | C0805 | Unpolarized capacitor
C12, C14, | 2 | 10u | C0805 10uF 16V X5R SAMSUNG | C0805 | Unpolarized capacitor
C13, | 1 | ? (10n/100n) |  | C0805 | Unpolarized capacitor
C17, C20, C24, C25, C26, C29, C30, | 7 | 100n | C0805 100nF 50V X7R SAMSUNG | C0805 | Unpolarized capacitor
C18, C21, C27, C28, | 4 | 10n | C0805 10nF 50V X7R SAMSUNG | C0805 | Unpolarized capacitor
D1, | 1 | BAT54C | ? | SOT23 | Diode, anode on pins 1 and 2
D2, D3, | 2 | ? (KP-2012EC/KP-2012SGC) |  | LED0805 | Light emitting diode
JP1, | 1 | TC2117-3.3VDBTR | TC2117-3.3VDBTR | SOT223 | 800mA Low-Dropout Linear Regulator, 1.5V fixed output, TO-220/TO-252/TO-263/SOT-223
JP2, | 1 | YPJ-8168X1 | YPJ-8168X2 | project_footprints:AUX_IN_3_5MM_2 | Audio-Jack 3-pole
JP3, JP5, | 2 | N/C | N/C | SIP_1x2 | Generic connector, single row, 2 positions for cables
JP4, | 1 | USB B MICRO R/A SMD WP | USB B MICRO R/A SMD WP | USB_MICROB | USB Micro Type B connector
JP6, | 1 | N/C | HEADER6 | SIP_1x6 | Generic connector, single row, 6 positions for line cable
JP7, | 1 | TS6P6C-PCB-U TE | TS6P6C-PCB-U TE | TM.310FACE_6X6
L1, L2, | 2 | BLM21PG300SN1D | L | L0805 | Ferrite Bead
Q1, | 1 | ? | ? | SOT23 | NPN transistor
Q2, | 1 | ? | ? | SOT23 | NPN transistor
R1, R2, R3, R9, R23, R24, R26, R28, R34, | 9 | 1k | R0805 1.0K 5% | R0805 | Resistor
R4, R5, R10, R11, R12, | 5 | 1M | R0805 1.0M 5% | R0805 | Resistor
R6, R8, R29, R30, R35, | 5 | R | R | R0805 | Resistor
R7, R13, R15, R16, R18, R20, R25, R27, | 8 | 10k | R0805 10K 5% | R0805 | Resistor
R14, R17, | 2 | 20K | R | R0805 | Resistor
R19, | 1 | 220 | R | R0805 | Resistor
R21, R22, | 2 | 2k2 | R | R0805 | Resistor
R31, R32, R33, | 3 | 4k7 | R0805 4.7K 5% | R0805 | Resistor
SW1, | 1 | SW_Push | SW_SPST | SWITCH | Single Pole Single Throw (SPST) switch
U1, | 1 | MCP73811T-420I/OT | MCP73811T-420I/OT | SMD_SOT23_5 | Simple, Miniature Single-Cell, Fully Integrated Li-Ion / Li-Polymer Charge Management Controllers, 85mA/450mA, 4.2V, SOT23-5
U2, | 1 | MCP6002-I/SN | MCP6002-I/SN | SO8_3.9x4.9mm_P1.27mm | 1MHz, Low-Power Op Amp, SOIC-8
U3, | 1 | INA826AIDR | INA826AIDR | SO8_3.9x4.9mm_P1.27mm | Single High Performance, Low Power, Rail-to-Rail Precision Instrumentation Amplifier, SOIC-8/MSOP-8
U4, | 1 | MAX86150 | MAX86150EFFT | MAX86150 | Biometric Sensors 3rd Gen High-Accuracy Pulse Oximetry and Heart Rate Bio Sensor
U5, | 1 | MCP1700-1802E/SOT23 | MCP1700-1802E/SOT23 | SOT23 | 250mA Low Quiscent Current LDO, 1.8V output, SOT-23
U6, | 1 | FT231XS | FT231XS | SSOP20_3.9x8.7mm_P0.635mm | Full Speed USB to Full Handshake UART, SSOP-20
U7, | 1 | ESP32-WROOM-32D | ESP32-WROOM-32D | ESP32WROOM | RF Module, ESP32-D0WD SoC, Wi-Fi 802.11b/g/n, Bluetooth, BLE, 32-bit, 2.7-3.6V, onboard antenna, SMD
U8, | 1 | MPU-6050 | MPU-6050 | QFN24_0.50mm_EP4.00mm | InvenSense 6-Axis Motion Sensor, Gyroscope, Accelerometer, I2C
