tregatti-tech/ESP32ECG/Box_3dprint/1.STL

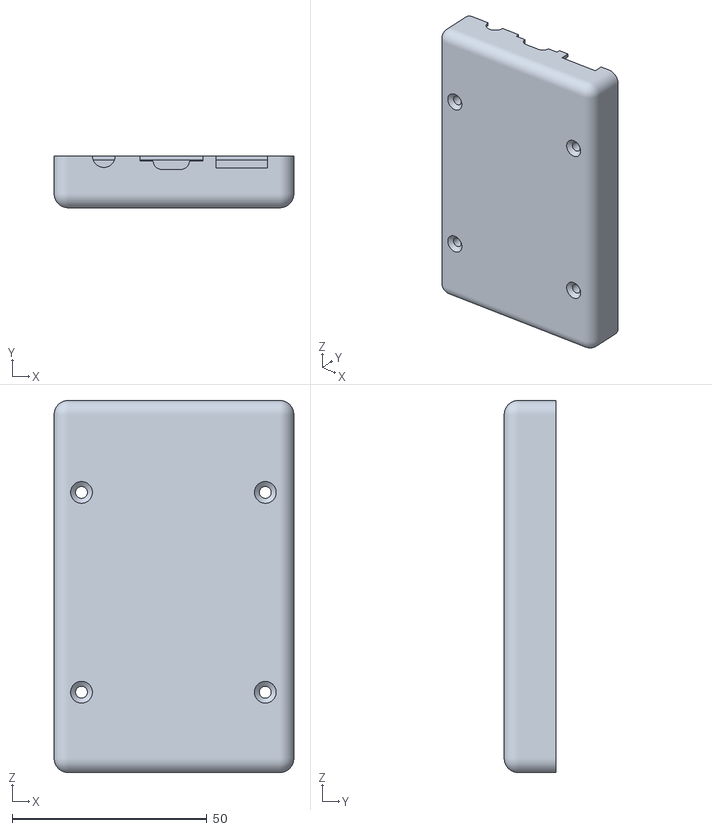
[picture p51: CAD file, 2021-08-14]
Box_3dprint/1.STL
61.5 x 13.2 x 95.4
