tregatti-tech/ESP32ECG/Box_3dprint/4.STL

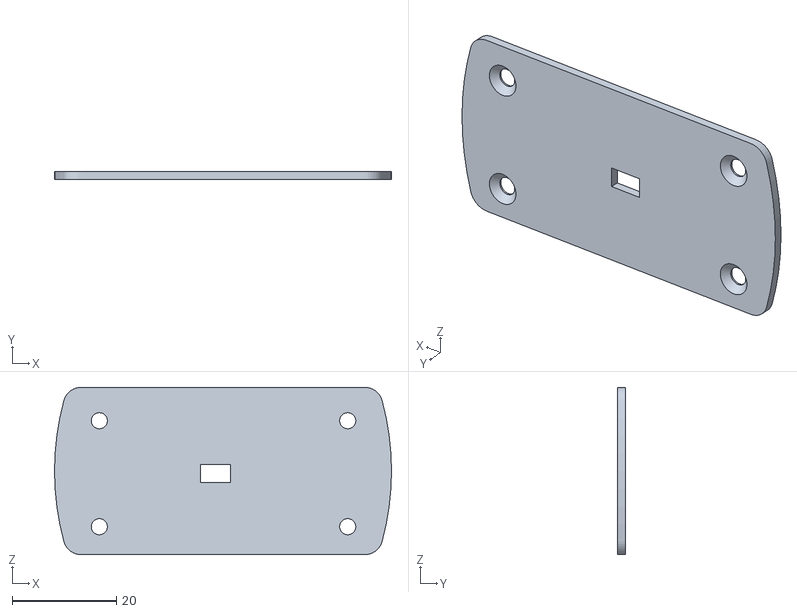
[picture p52: CAD file, 2021-08-14]
Box_3dprint/4.STL
64.7 x 1.50 x 32.1
