tregatti-tech/ESP32ECG/Box_3dprint/2.STL

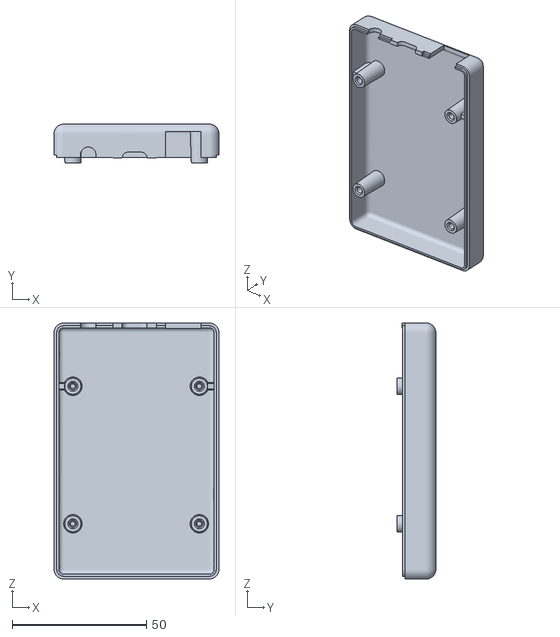
[picture p53: CAD file, 2021-08-14]
Box_3dprint/2.STL
61.5 x 14.5 x 95.4
