tregatti-tech/ESP32ECG/Box_3dprint/3.STL

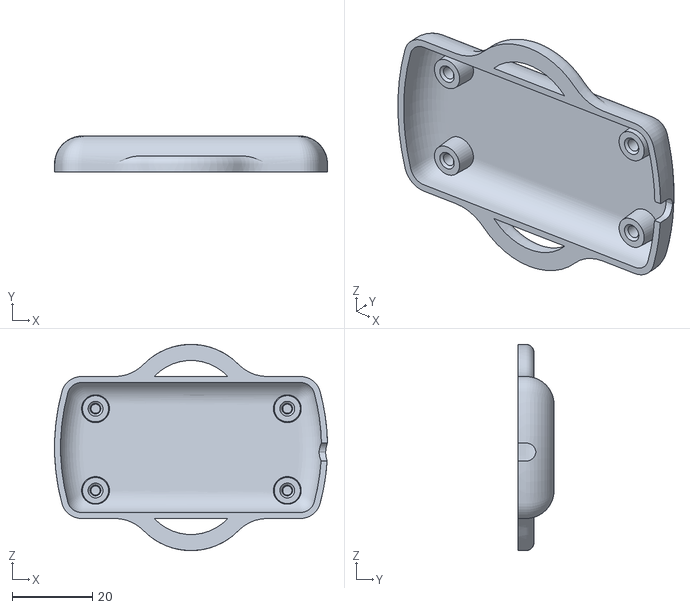
[picture p54: CAD file, 2021-08-14]
Box_3dprint/3.STL
67.9 x 9.00 x 51.3
