tregatti-tech/ESP32ECG/Visualisation/tregatti_stable.pdf

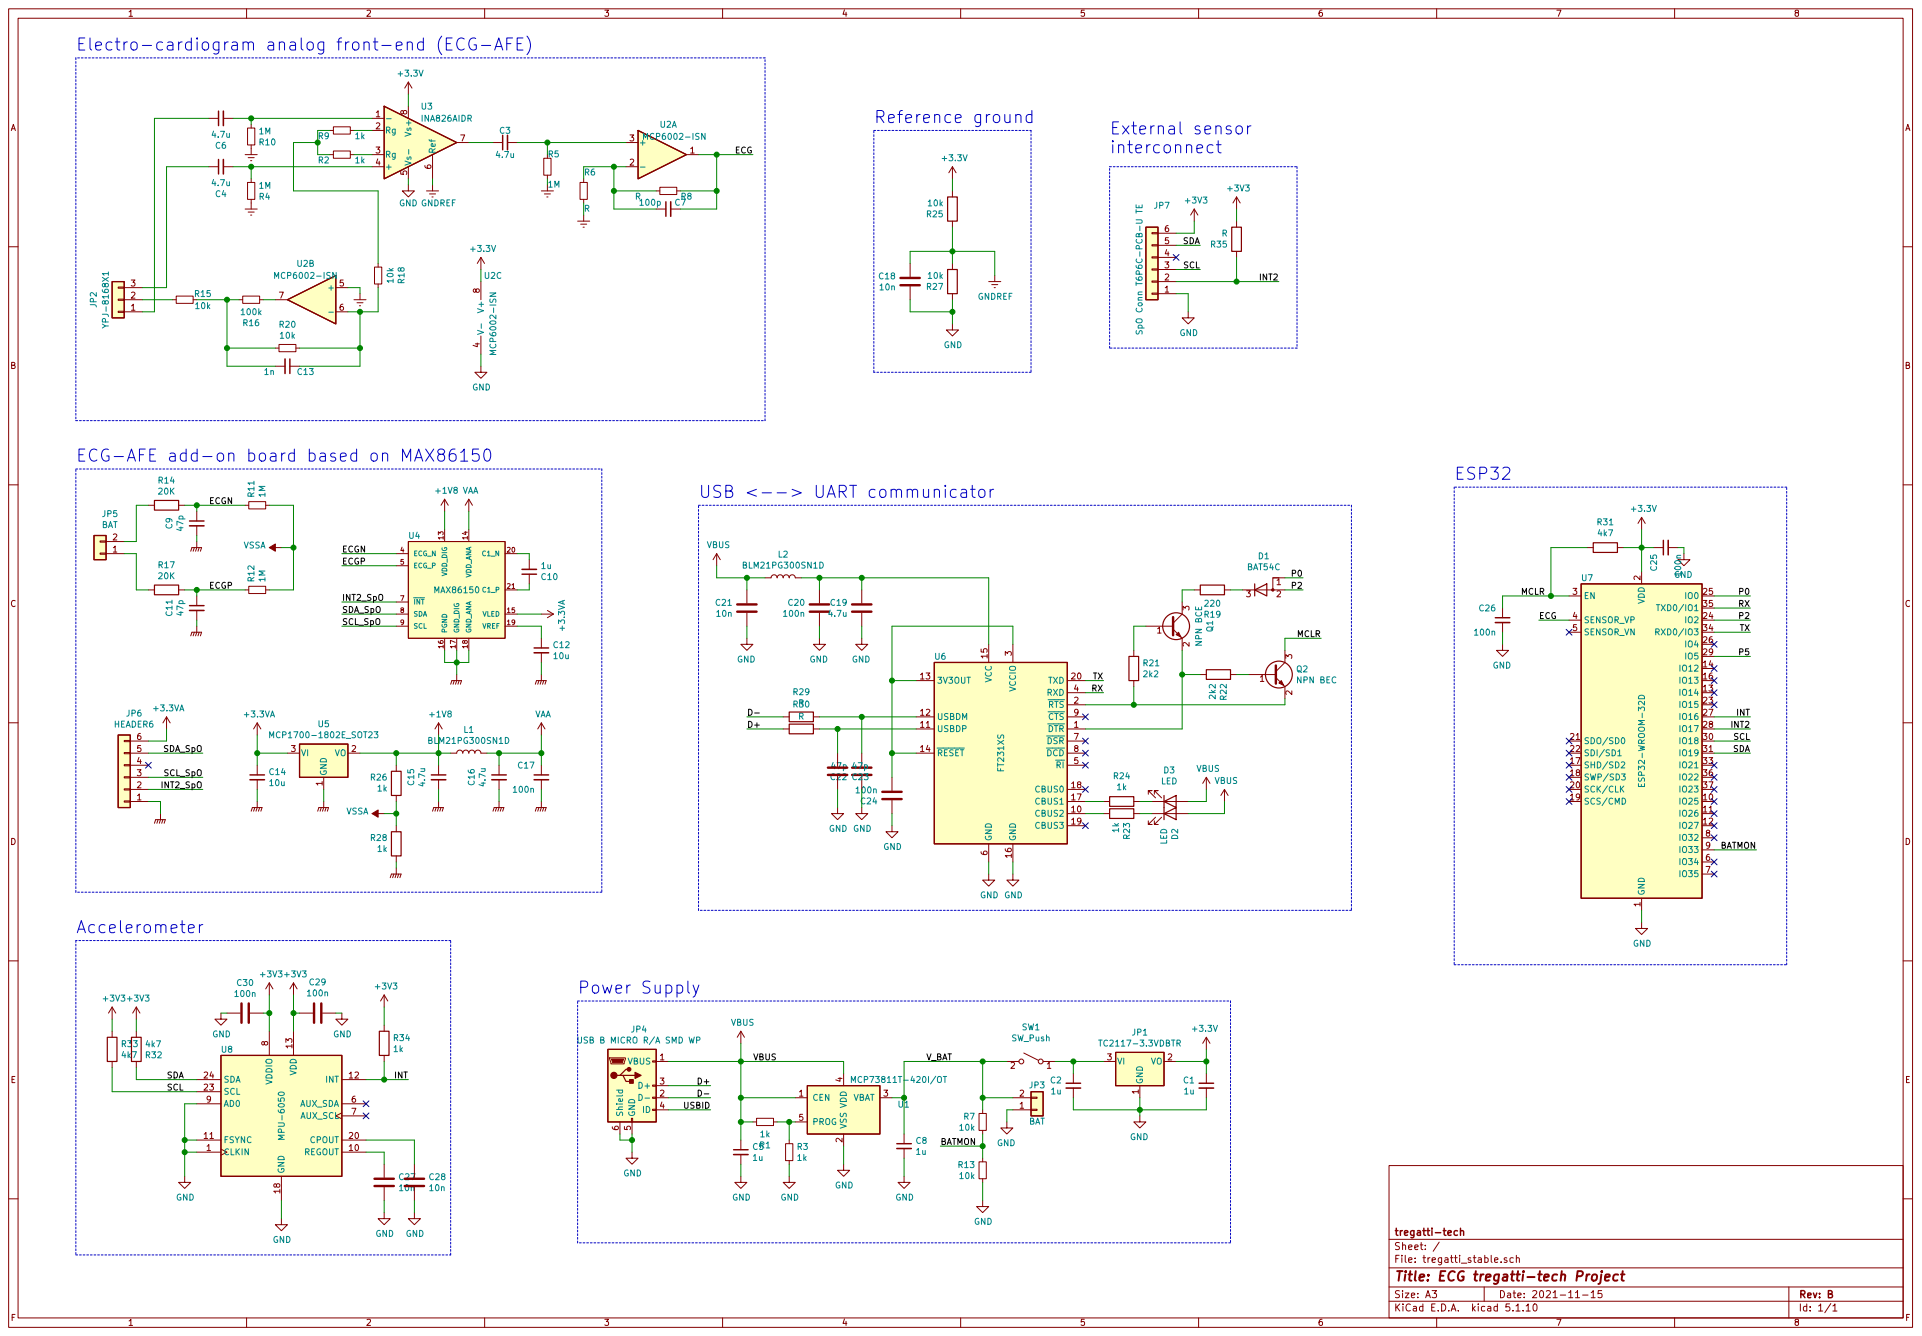
[picture p55: page 1]

Electro-cardiogram analog front-end (ECG-AFE)

External sensor
interconnect
JP7 SpO Conn T6P6C-PCB-U TE

ECG-AFE add-on board based on MAX86150

1 VO 2 VI 3 U5 MCP1700-1802E_SOT23 +3.3VA VDD_DIG 13 VDD_ANA 14 VLED 15 PGND 16 GND_DIG 17 GND_ANA 18 VREF 19 C1_N 20 C1_P 21 ECG_N 4 ECG_P 5
VSSA

2 SCK/CLK 20 SDO/SD0 21 SDI/SD1 22

JP4 USB B MICRO R/A SMD WP GND GND

File: tregatti_stable.sch Sheet: / tregatti-tech GND

Id: 1/1 Title: ECG tregatti-tech Project
