tregatti-tech/ESP32ECG/KiCAD_files/tregatti-ecg/tregatti_stable.kicad_pcb

## KiCad design KiCAD_files/tregatti-ecg/tregatti_stable.kicad_pcb (2021-12-08)

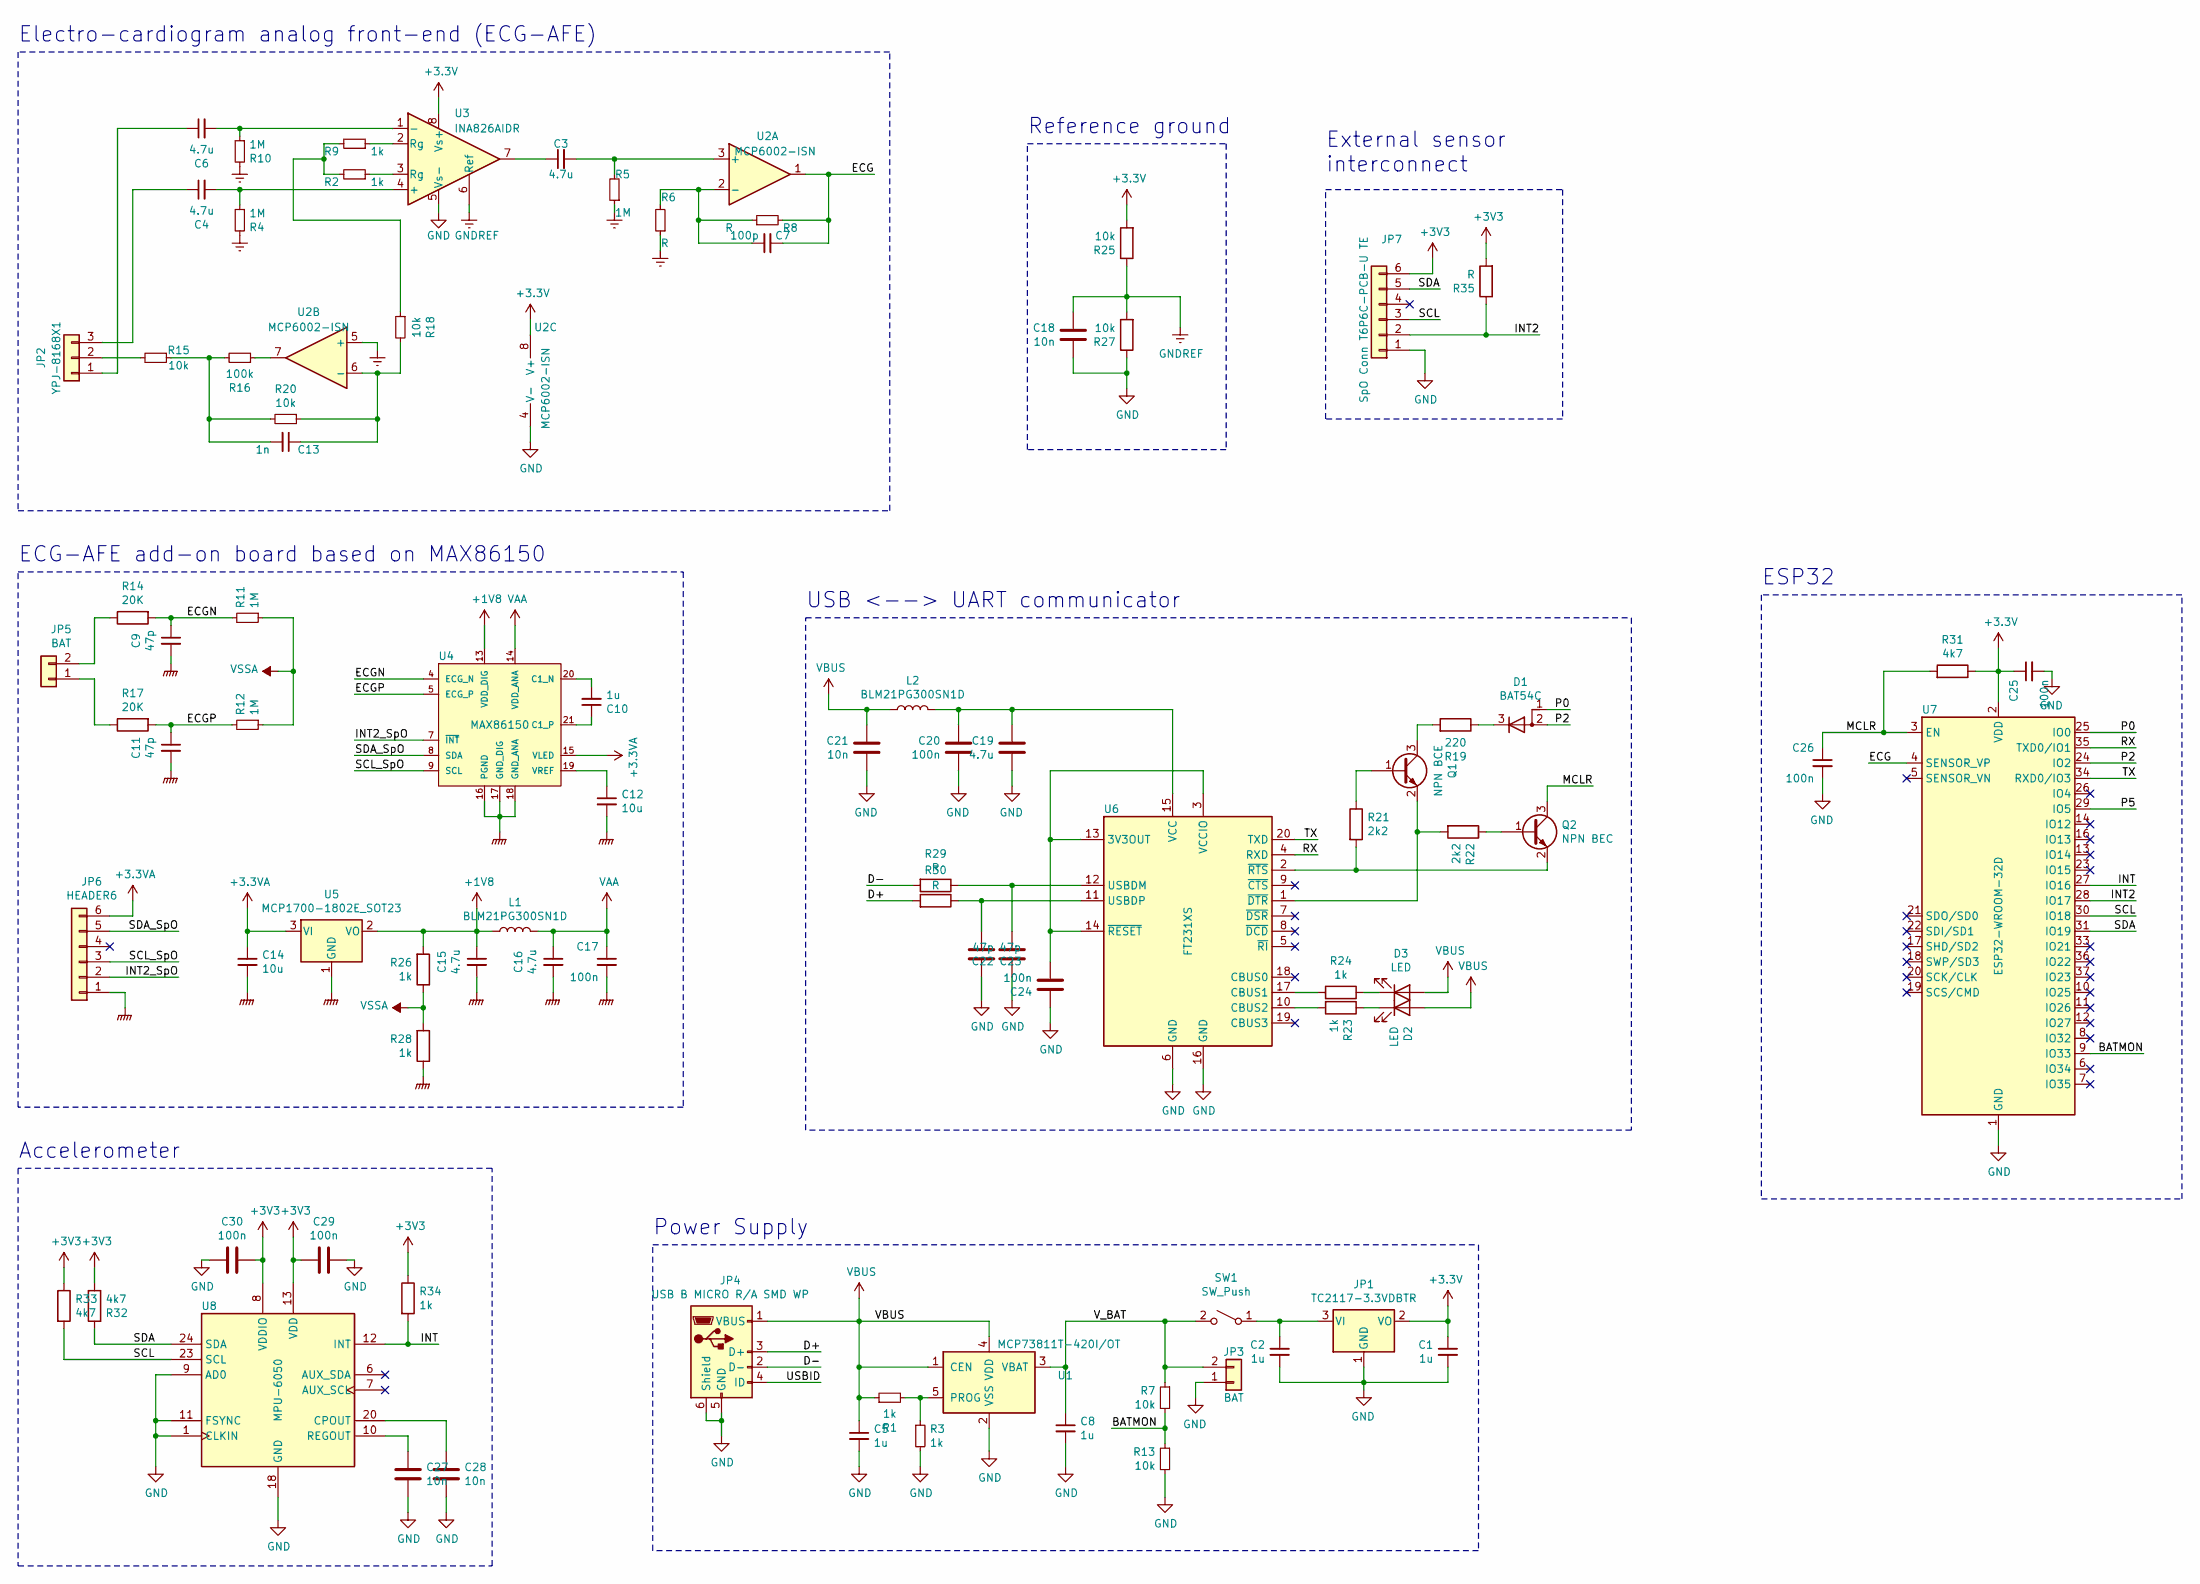
[picture p56: schematic tregatti_stable.sch, ECG tregatti-tech Project]

Parts:
C1, C2, C5, C8, C10: 1u; SMD_C0805
C3, C4, C6, C15, C16, C19: 4.7u; SMD_C0805
C7: 100p; SMD_C0805
C9, C11, C22, C23: 47p; SMD_C0805
C12, C14: 10u; SMD_C0805
C13: 1n; SMD_C0805
C17, C20, C24, C25, C26, C29, C30: 100n; SMD_C0805
C18, C21, C27, C28: 10n; SMD_C0805
D1: BAT54C; SMD_SOT23_123
D2, D3: LED; SMD_LED0805
JP1: TC2117-3.3VDBTR; SMD_SOT223
JP2: YPJ-8168X1; AUX_IN_3_5MM_2
JP3, JP5: BAT; SIP_1x2
JP4: USB B MICRO R/A SMD WP; USB_MICRO3
JP6: HEADER6; SIP_1x6
JP7: SpO Conn T6P6C-PCB-U TE; TM.310FACE_6X6
L1, L2: BLM21PG300SN1D; SMD_R0805
Q1: NPN BCE; SMD_SOT23_123
Q2: NPN BEC; SMD_SOT23_123
R1, R2, R3, R9, R23, R24, R26, R28, R34: 1k; SMD_R0805
R4, R5, R10, R11, R12: 1M; SMD_R0805
R6, R8, R29, R30, R35: R; SMD_R0805
R7, R13, R15, R18, R20, R25, R27: 10k; SMD_R0805
R14, R17: 20K; SMD_R0805
R16: 100k; SMD_R0805
R19: 220; SMD_R0805
R21, R22: 2k2; SMD_R0805
R31, R32, R33: 4k7; SMD_R0805
SW1: SW_Push; SWITCH_ONOFF
U1: MCP73811T-420I/OT; SMD_SOT23_5
U2: MCP6002-ISN; SO8_3.9x4.9mm_P1.27mm
U3: INA826AIDR; SO8_3.9x4.9mm_P1.27mm
U4: MAX86150
U5: MCP1700-1802E_SOT23; SMD_SOT23_123
U6: FT231XS; SSOP20_3.9x8.7mm_P0.635mm
U7: ESP32-WROOM-32D; ESP32WROOM
U8: MPU-6050; QFN24_0.50mm_EP4.00mm

Connections:
+1V8: C15.1, L1.1, R26.2, U4.13 (VDD_DIG), U5.2 (VO)
+3.3VA: C14.1, JP6.6, U4.15 (VLED), U5.3 (VI)
/BATMON: R7.2, R13.1, U7.9 (IO33)
/D+: JP4.3 (D+), R30.2
/D-: JP4.2 (D-), R29.2
/ECG: C7.2, R8.2, U2.1, U7.4 (SENSOR_VP)
/ECGN: C9.1, R11.2, R14.2, U4.4 (ECG_N)
/ECGP: C11.1, R12.2, R17.2, U4.5 (ECG_P)
/INT: R34.2, U7.27 (IO16), U8.12 (INT)
/INT2: JP7.2, R35.1, U7.28 (IO17)
/INT2_SpO: JP6.2, U4.7 (~INT~)
/MCLR: C26.1, Q2.3 (C), R31.2, U7.3 (EN)
/P0: D1.1 (A), U7.25 (IO0)
/P2: D1.2 (A), U7.24 (IO2)
/P5: U7.29 (IO5)
/RX: U6.4 (RXD), U7.35 (TXD0/IO1)
/SCL: JP7.3, R33.2, U7.30 (IO18), U8.23 (SCL)
/SCL_SpO: JP6.3, U4.9 (SCL)
/SDA: JP7.5, R32.2, U7.31 (IO19), U8.24 (SDA)
/SDA_SpO: JP6.5, U4.8 (SDA)
/TX: U6.20 (TXD), U7.34 (RXD0/IO3)
/USBID: JP4.4 (ID)
/V_BAT: C8.1, JP3.2, R7.1, SW1.2 (B), U1.3 (VBAT)
GND: C1.2, C2.2, C5.2, C8.2, C18.2, C19.2, C20.2, C21.2, C22.2, C23.2, C24.2, C25.2, C26.2, C27.2, C28.2, C29.2, C30.2, JP1.1 (GND), JP3.1, JP4.5 (GND), JP4.6 (Shield), JP7.1, R3.2, R13.2, R27.1, U1.2 (VSS), U2.4 (V-), U3.5 (Vs-), U6.6 (GND), U6.16 (GND), U7.1 (GND), U7.15 (GND), U7.38 (GND), U7.39 (GND), U8.1 (CLKIN), U8.9 (AD0), U8.11 (FSYNC), U8.18 (GND)
GNDPWR: C9.2, C11.2, C12.2, C14.2, C15.2, C16.2, C17.2, JP6.1, R28.1, U4.16 (PGND), U4.17 (GND_DIG), U4.18 (GND_ANA), U5.1 (GND)
GNDREF: C18.1, R4.2, R5.1, R6.1, R10.2, R25.1, R27.2, U2.5 (+), U3.6 (Ref)
unnamed: C2.1, JP1.3 (VI), SW1.1 (A)
unnamed: C3.1, U3.7
unnamed: C3.2, R5.2, U2.3 (+)
unnamed: C4.1, JP2.3
unnamed: C4.2, R4.1, U3.4 (+)
unnamed: C6.1, JP2.1
unnamed: C6.2, R10.1, U3.1 (-)
unnamed: C7.1, R6.2, R8.1, U2.2 (-)
unnamed: C10.1, U4.21 (C1_P)
unnamed: C10.2, U4.20 (C1_N)
unnamed: C12.1, U4.19 (VREF)
unnamed: C13.1, R18.2, R20.1, U2.6 (-)
unnamed: C13.2, R15.1, R16.2, R20.2
unnamed: C19.1, C20.1, L2.1, U6.15 (VCC)
unnamed: C22.1, R29.1, U6.12 (USBDM)
unnamed: C23.1, R30.1, U6.11 (USBDP)
unnamed: C24.1, U6.3 (VCCIO), U6.13 (3V3OUT), U6.14 (~RESET)
unnamed: C27.1, U8.10 (REGOUT)
unnamed: C28.1, U8.20 (CPOUT)
unnamed: D1.3 (K), R19.1
unnamed: D2.1 (K), R23.1
unnamed: D3.1 (K), R24.1
unnamed: JP2.2, R15.2
unnamed: JP5.1, R17.1
unnamed: JP5.2, R14.1
unnamed: Q1.1 (B), R21.1
unnamed: Q1.2 (E), R22.2, U6.1 (~DTR)
unnamed: Q1.3 (C), R19.2
unnamed: Q2.1 (B), R22.1
unnamed: Q2.2 (E), R21.2, U6.2 (~RTS)
unnamed: R1.2, R3.1, U1.5 (PROG)
unnamed: R2.1, U3.3 (Rg)
unnamed: R9.1, U3.2 (Rg)
unnamed: R16.1, U2.7
unnamed: R2.2, R9.2, R18.1
unnamed: R23.2, U6.10 (CBUS2)
unnamed: R24.2, U6.17 (CBUS1)
VAA: C16.1, C17.1, L1.2, U4.14 (VDD_ANA)
VBUS: C5.1, C21.1, D2.2 (A), D3.2 (A), JP4.1 (VBUS), L2.2, R1.1, U1.1 (CEN), U1.4 (VDD)
VSSA: R11.1, R12.1, R26.1, R28.2

Notes on the sheet:
Accelerometer
USB <--> UART communicator
Power Supply
Electro-cardiogram analog front-end (ECG-AFE)
ECG-AFE add-on board based on MAX86150
ESP32
External sensor interconnect
Reference ground

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
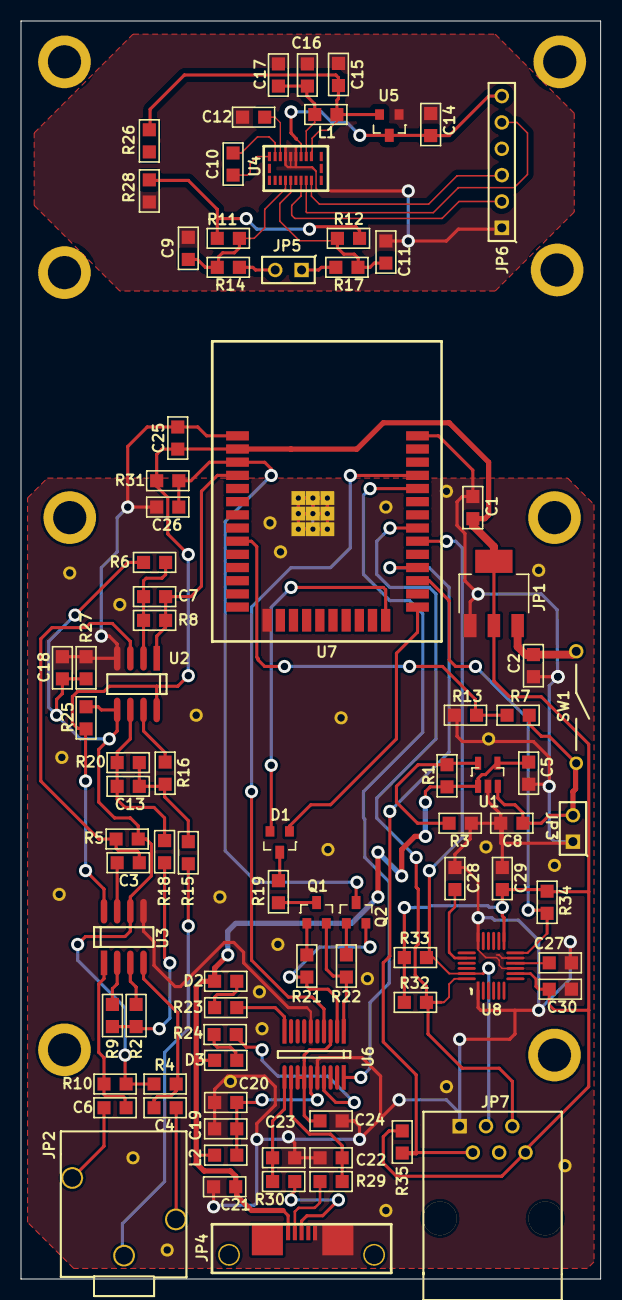
[picture p57: board tregatti_stable.kicad_pcb from above]

Board: 2 copper layers, 55.9 x 121.3 mm, 121 parts (0 on the bottom side), 65 nets.

Other parts of the board:
89, 90, 91, 92, 93, 94, 95, 96: HOLE_3.2_5
97, 98, 99, 100, 101, 102, 103, 104, 105, 106, 107, 108, 109, 110, 111, 112, 113, 114, 115, 116, 117, 118, 119, 120, 121: HOLE_NO_COPPER
