tregatti-tech/ESP32ECG/(commit log)

2021-08-14 STL files for main box and oxymeter
    [1.STL, 2.STL, 3.STL, 4.STL]
2021-08-14 KiKad version of both board
    //fix copper plates
    [ONLY_ECG_fix.kicad_pcb]
2021-08-19 Initial bom without ESP-Wroom
    BOM for the project, please note that some component orders are by 10, as it is cheaper this way.
    [BOM - Sheet1.csv]
2021-11-17 simple sample
2021-12-08 Moved to folder
    [1.STL, 2.STL, 3.STL, 4.STL]
2021-12-08 KiCAD design files
    [bom.ods, tregatti_stable.kicad_pcb, tregatti_stable.sch]
2021-12-08 old files
    [BOM - Sheet1.csv, ONLY_ECG_fix.kicad_pcb]
2021-12-10 add sample data
    [data1.csv, data2.csv, ecg.csv, ecg1.csv]
2021-12-15 Color change and filtering
2021-12-15 data from server made to arrive in 1000 samples per second, some css fixes
2021-12-17 add an animated css recording button
2022-01-22 low-pass-filter button, css and html added only
2022-01-22 low-pass-filter js module added, needs work on injecting it into d3example.js; in d3example.js - formula for heart rate updated
2022-01-27 data for testing changed to original data from device, ws_server updated, client recieving data updated for this purpose
    [ws.csv]
2022-01-27 Original data used with 2 filters
2022-01-27 Low pass filter and RPeak detection updates
2022-02-05 web socket (ws) changed with socket.io library
